hjus36/STM32-Flight-System/hardware/LKM_FC_V1/bom/LKM_FC_V1_BOM.pdf

STM32-Flight-System / hardware / LKM_FC_V1 / bom | ASSEMBLY BOM | 01

# LKM_FC_V1 | Assembly BOM

### STM32-Flight-System · 공장 실장용 부품 명세서 · Source: LKM_JLCPCB_BOM.csv

Unique MPN groups
52

구매·조립용 품목 그룹

Placements / board
139

보드 1장당 공장 실장

Placements / 5 boards
695

손실 여유 수량 제외

이 표는 JLCPCB 조립용 CSV를 바탕으로 작성했으며, 전체 회로도 146개 Component 목록과 다릅니다. 수동 실장 헤더(J1/J4/J5/J8), DNP(R58), 직접 배선용 J6, 별도 실장하지 않는 TP1은 공장 실장 목록에서 제외됩니다.

No. | Designator | Qty | Manufacturer | Manufacturer Part Number | Footprint | LCSC Part #
01 | BZ1 | 1 | Same Sky (formerly CUI Devices) | CMT-8540S-SMT-TR | CMT_8540S_SMT_TR_8P5X8P5_4LAND | C22359715
02 | C1 | 1 | Murata | GRM1885C1H332JA01D | TDK_C1608_0603_REFLOW | C77036
03 | C2,C9,C10,C11,C12,C13,C14,C17,C19,C24,C25,C26,C27,
| C30,C33,C34,C35,C36,C37,C39,C40,C42,C43,C44,C45 | 25 | TDK | C1608X7R1H104K080AA | TDK_C1608_0603_REFLOW | C72453
04 | C3,C4,C5,C6,C41 | 5 | TAIYO YUDEN | MCAST32MSB7226KPNA01 | TAIYO_YUDEN_MCAS_3225_REFLOW | C5372271
05 | C7,C18 | 2 | Murata | GCM1885C1H103JA16D | TDK_C1608_0603_REFLOW | C1517789
06 | C8 | 1 | Murata | GCM2195C1H153JA16D | MURATA_GCM21_0805_REFLOW | C161251
07 | C15,C38,C46 | 3 | Taiyo Yuden | MCJCG31LBB7106KTPA01 | TDK_C3216_1206_REFLOW | C5767734
08 | C16 | 1 | TDK | CGA3E1X7R1V105K080AE | TDK_C1608_0603_REFLOW | C2167404
09 | C20,C21,C31 | 3 | TDK | C1608X7R1A225K080AC | TDK_C1608_0603_REFLOW | C3853756
10 | C22,C23 | 2 | Murata | GCM1885C2A160FA16D | TDK_C1608_0603_REFLOW | C17345794
11 | C28,C29 | 2 | Murata | GCM1885C2A220FA16D | TDK_C1608_0603_REFLOW | C2169896
12 | C32 | 1 | TDK | CGA3E2X7R1H103K080AA | TDK_C1608_0603_REFLOW | C171819
13 | D1 | 1 | Littelfuse | SMAJ6.0CA | SMAJ6.0CA | C80275
14 | D2 | 1 | Diodes Incorporated | BZT52C5V1-7-F | BZT52C5V1_7F_SOD123_DIODES | C151588
15 | D3 | 1 | Littelfuse | SMAJ13A | SMAJ13A | C148214
16 | D4,D5,D6,D7,D8,D9,D10 | 7 | Texas Instruments | TPD2E2U06DRLR | TPD2E2U06DRLR_DRL5_P0.50 | C1972959
17 | D11 | 1 | Vishay | SS14-E3/61T | SS14_E3_61T_SMA_DO214AC | C47460
18 | D12,D15 | 2 | Kingbright | APT1608SURCK | APT1608SURCK_LED1608_1P6X0P8 | C5875723
19 | D13,D16 | 2 | Kingbright | APT1608SGC | APT1608SGC_LED1608_1P6X0P8 | C5875754
20 | D14 | 1 | Kingbright | APT1608SYCK | APT1608SYCK_LED1608_1P6X0P8 | C5875726
21 | J2,J3 | 2 | Molex | 530470510 | Molex_53047-0510 | C471412
22 | Q1 | 1 | Diodes Incorporated | DMP2035U-7 | DMP2035U7_SOT23_DIODES | C110499
23 | Q2 | 1 | Alpha & Omega Semiconductor | AO3400A | AO3400A_SOT23_AOS | C20917
24 | R1,R53,R54,R55,R57 | 5 | Vishay | CRCW06031K00FKEA | VISHAY_CRCW0603_REFLOW | C844920
25 | R2 | 1 | Vishay | CRCW0603240KFKEA | VISHAY_CRCW0603_REFLOW | C3008874
26 | R3,R40,R42,R44,R46,R48,R50,R52 | 8 | Vishay | CRCW0603100KFKEA | VISHAY_CRCW0603_REFLOW | C844916

STM32-Flight-System / hardware / LKM_FC_V1 / bom | ASSEMBLY BOM | 02
No. | Designator | Qty | Manufacturer | Manufacturer Part Number | Footprint | LCSC Part #
27 | R4 | 1 | Vishay | CRCW06031K02FKEA | VISHAY_CRCW0603_REFLOW | C844136
28 | R5 | 1 | Vishay | TNPW060331K6BEEA | VISHAY_TNPW0603_IPC_REFLOW | C843870
29 | R6 | 1 | Vishay | TNPW060310K1BEEA | VISHAY_TNPW0603_IPC_REFLOW | C4353204
30 | R7 | 1 | Vishay | CRCW0603620RFKEA | VISHAY_CRCW0603_REFLOW | C844181
31 | R8 | 1 | Vishay | TNPW0603100KBEEA | VISHAY_TNPW0603_IPC_REFLOW | C844888
32 | R9 | 1 | Vishay | TNPW060310K0BEEA | VISHAY_TNPW0603_IPC_REFLOW | C844890
33 | R10 | 1 | Vishay | TNPW06031K00BEEA | VISHAY_TNPW0603_IPC_REFLOW | C844891
34 | R11 | 1 | Vishay | TNPW060347K0BEEA | VISHAY_TNPW0603_IPC_REFLOW | C2089026
35 | R12,R15,R16 | 3 | Vishay | CRCW06030000Z0EA | VISHAY_CRCW0603_REFLOW | C844915
36 | R13,R14,R17,R18,R19,R20,R23,R24,R25 | 9 | Vishay | CRCW060310K0FKEA | VISHAY_CRCW0603_REFLOW | C844918
37 | R21,R22,R26,R27,R56 | 5 | Vishay | CRCW06032K20FKEA | VISHAY_CRCW0603_REFLOW | C844925
38 | R28,R31,R36,R39,R41,R43,R45,R47,R49 | 9 | Vishay | CRCW060333R0FKEA | VISHAY_CRCW0603_REFLOW | C844927
39 | R29,R32,R34,R37,R51 | 5 | Vishay | CRCW0603100RFKEA | VISHAY_CRCW0603_REFLOW | C844917
40 | R30,R33,R35,R38 | 4 | Vishay | CRCW060347K0FKEA | VISHAY_CRCW0603_REFLOW | C844929
41 | SW1 | 1 | Omron | B3U-1000P | B3U1000P_SMD_3X2P5 | C231329
42 | U1 | 1 | STMicroelectronics | STM32F405RGT6 | STM32F405RGT6_LQFP64_10X10_P0.50_ST | C15742
43 | U2 | 1 | CEVA | BNO086 | BNO086_LGA28_5.2X3.8_P0.50_CEVA | C5264422
44 | U3 | 1 | TDK InvenSense | ICM-20602 | ICM20602_LGA16_3X3_P0.50 | C97633
45 | U4 | 1 | STMicroelectronics | LPS22HHTR | LPS22HH_HLGA10_2X2_P0.50 | C2827824
46 | U5 | 1 | Microchip | AT24C08C-SSHM-T | AT24C08C_SOIC8_SN_P1.27 | C31422
47 | U8 | 1 | Texas Instruments | TPS259531DSGR | TPS259531DSGR_WSON8_DSG_2X2_P0.50_EP | C2155674
48 | U9 | 1 | Texas Instruments | TPS7A9001DSKR | TPS7A9001DSKR_WSON10_DSK_2.5X2.5_P0.50_EP | C840111
49 | U10 | 1 | Texas Instruments | TMUX1511PWR | TMUX1511PWR_TSSOP14_PW_4.4X5_P0.65 | C2866750
50 | U11,U12,U13,U14 | 4 | Texas Instruments | SN74LVC1G17DBVR | SN74LVC1G17DBVR_DBV5_P0.95 | C7836
51 | Y1 | 1 | Abracon | ABM3B-8.000MHZ-10-D1G-T | ABM3B_8MHZ_5032_4PAD | C1985378
52 | Y2 | 1 | Abracon | ABS07-32.768KHZ-T | ABS07_32K768_3215_2PAD | C130253

참고: Designator 및 Quantity는 CSV와 대조되었으며 52개 그룹·139개 고유 실장 위치로 일치합니다. Footprint 명칭은 라이브러리 이름으로, 실제 Manufacturer 및 MPN과 항상 동일한 이름을 갖는 것은 아닙니다. 최종 주문 및 조립 가능 여부는 제조사에서 별도로 확인해야 합니다.
