hjus36/STM32-Flight-System/testing/offline-sil/results/sil_v1_20261106_040855/trace_all_scenarios.csv

scenario | t_ms | t_s | injection | target_roll_deg | roll_deg | target_pitch_deg | pitch_deg | roll_rate_rad_s | pitch_rate_rad_s | requested_roll_torque_nm | achieved_roll_torque_nm | requested_pitch_torque_nm | achieved_pitch_torque_nm | motor1_model_n | motor2_model_n | motor3_model_n | motor4_model_n | virtual_valid | esc_enabled | controller_ready | actuator_state | actuator_result | bno_age_ms | icm_age_ms | host_skew_ms | timepair_result | frame_result | buffer_result | scheduler_result | preview_result | mixer_ok | model_step_count
baseline | 10 | 0.010 | 0 | 0.000000 | 0.000000 | 0.000000 | 0.000000 | 0.0000000 | 0.0000000 | 0.0000000 | 0.0000000 | 0.0000000 | 0.0000000 | 0.0000000 | 0.0000000 | 0.0000000 | 0.0000000 | 0 | 0 | 0 | 1 | DISARMED | 2 | 1 | 1 | OBSERVATION_ONLY | SYNTHETIC_ONLY | OK | OK | FEEDBACK | 0 | 0
baseline | 20 | 0.020 | 0 | 0.000000 | 0.000000 | 0.000000 | 0.000000 | 0.0000000 | 0.0000000 | 0.0000000 | 0.0000000 | 0.0000000 | 0.0000000 | 0.0000000 | 0.0000000 | 0.0000000 | 0.0000000 | 0 | 0 | 0 | 2 | ARMED_VIRTUAL | 2 | 1 | 1 | OBSERVATION_ONLY | SYNTHETIC_ONLY | OK | OK | FEEDBACK | 0 | 0
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
