hjus36/STM32-Flight-System/hardware/LKM_FC_V1/pcb-layout/LKM_FC_V1_PCB_Layout.pdf

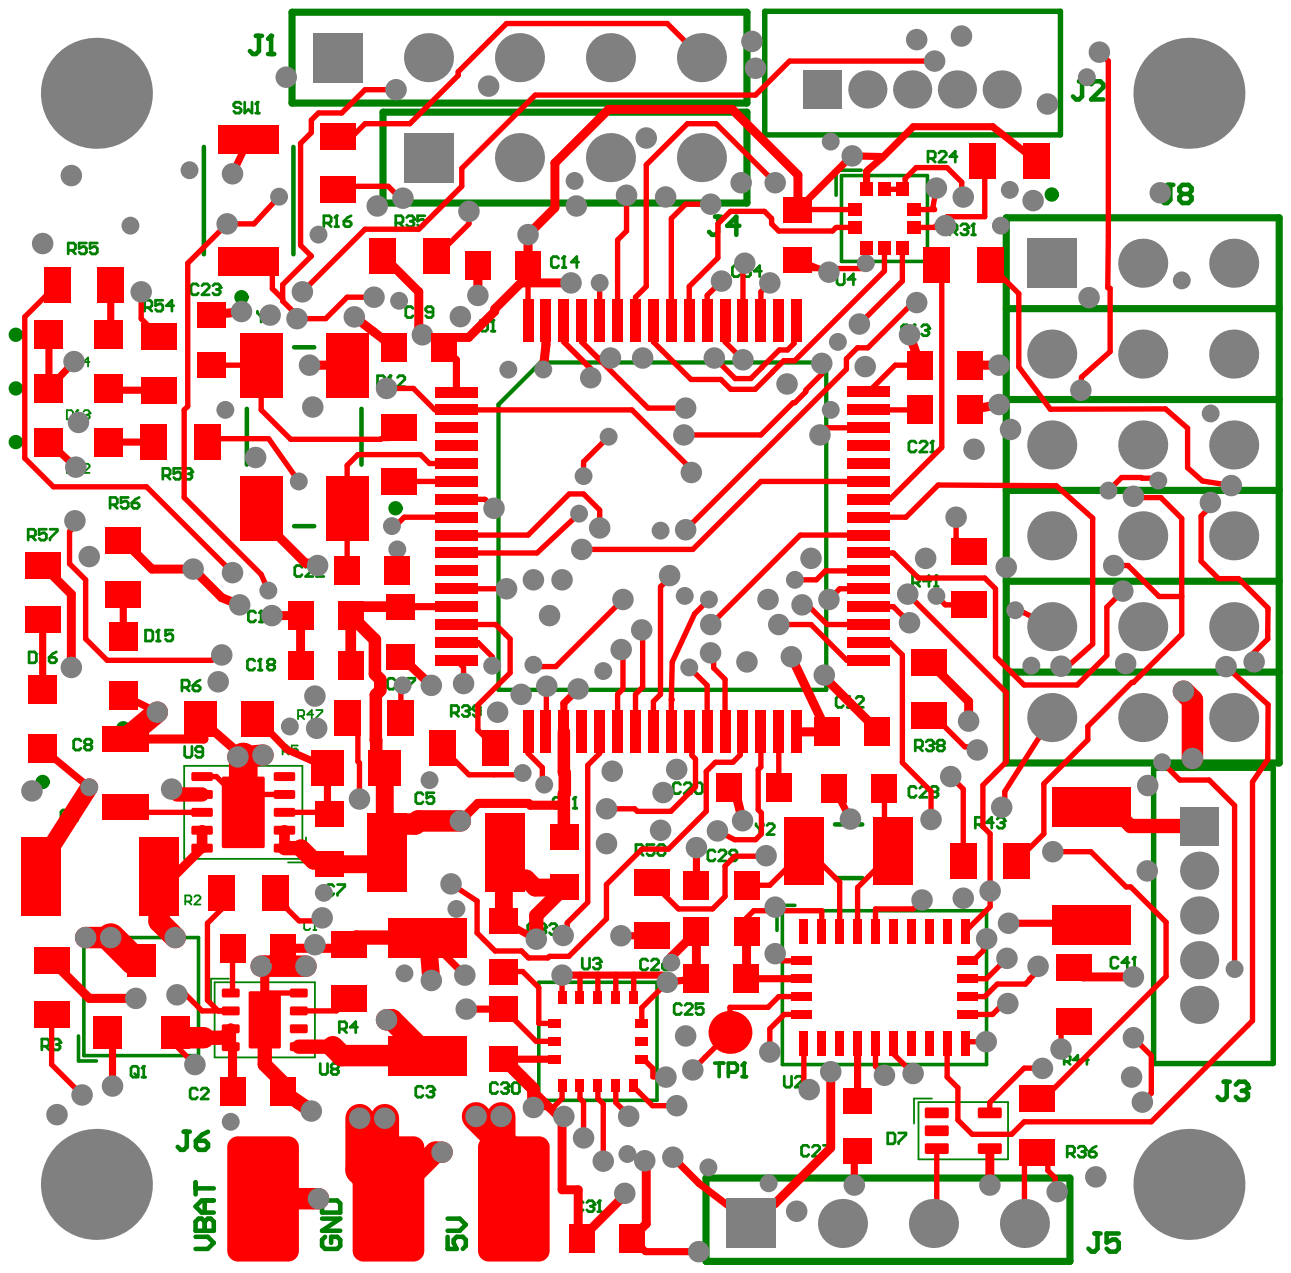
[picture p9: page 1]

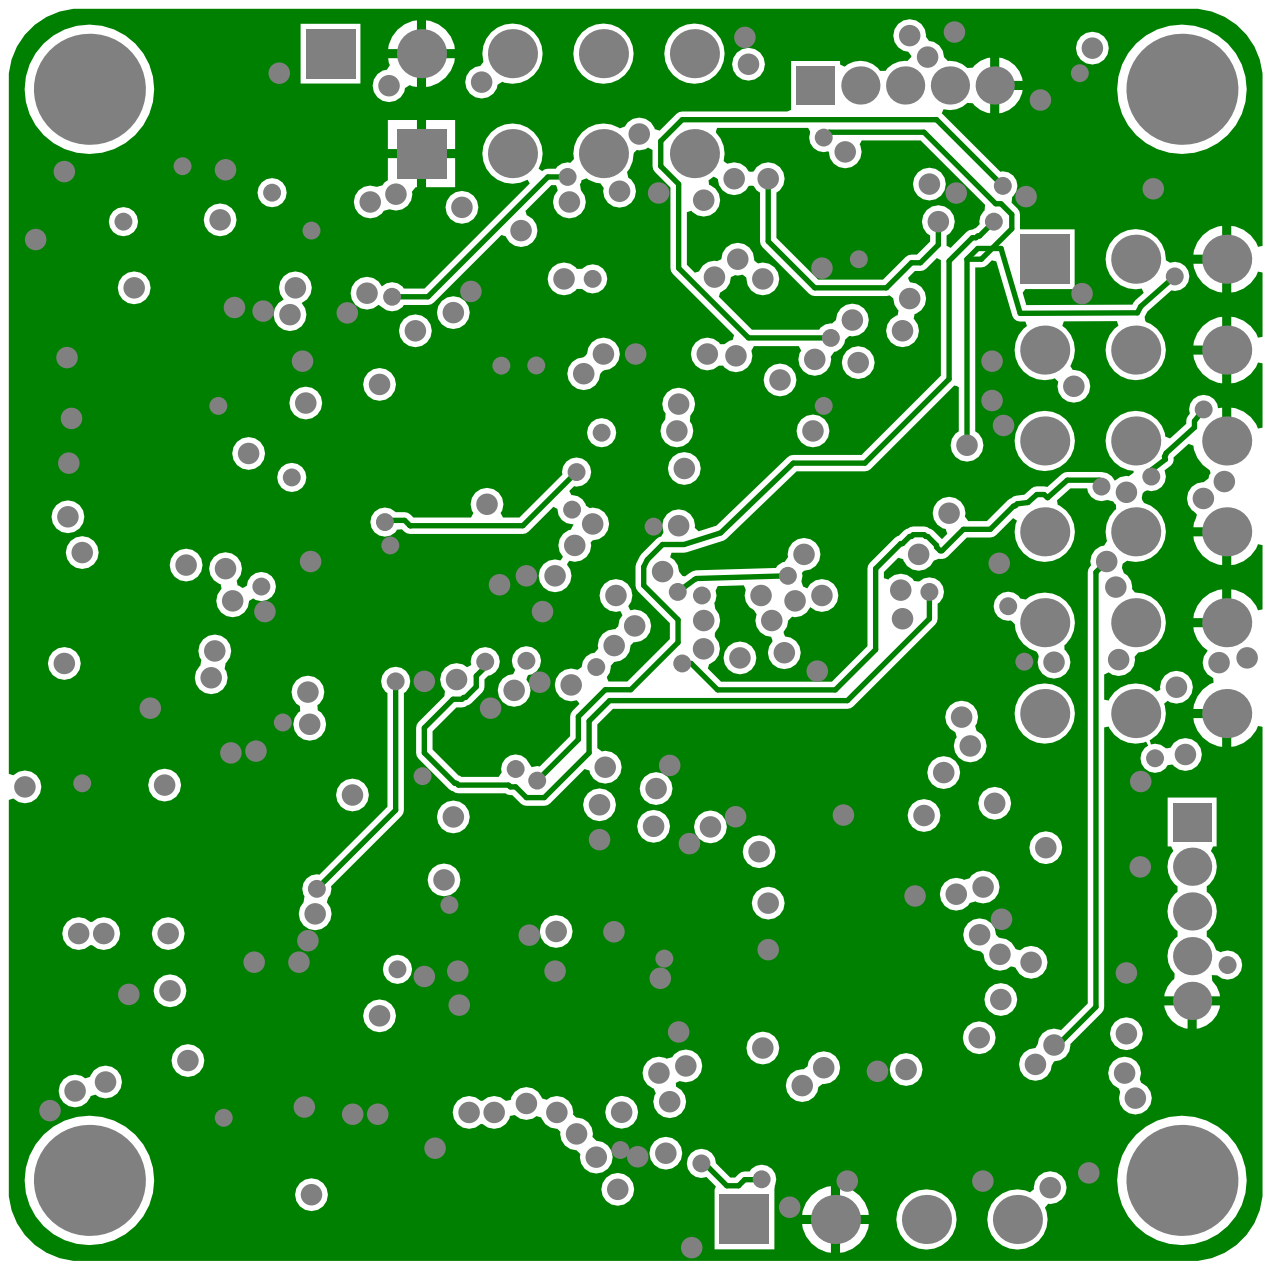
[picture p10: page 2]

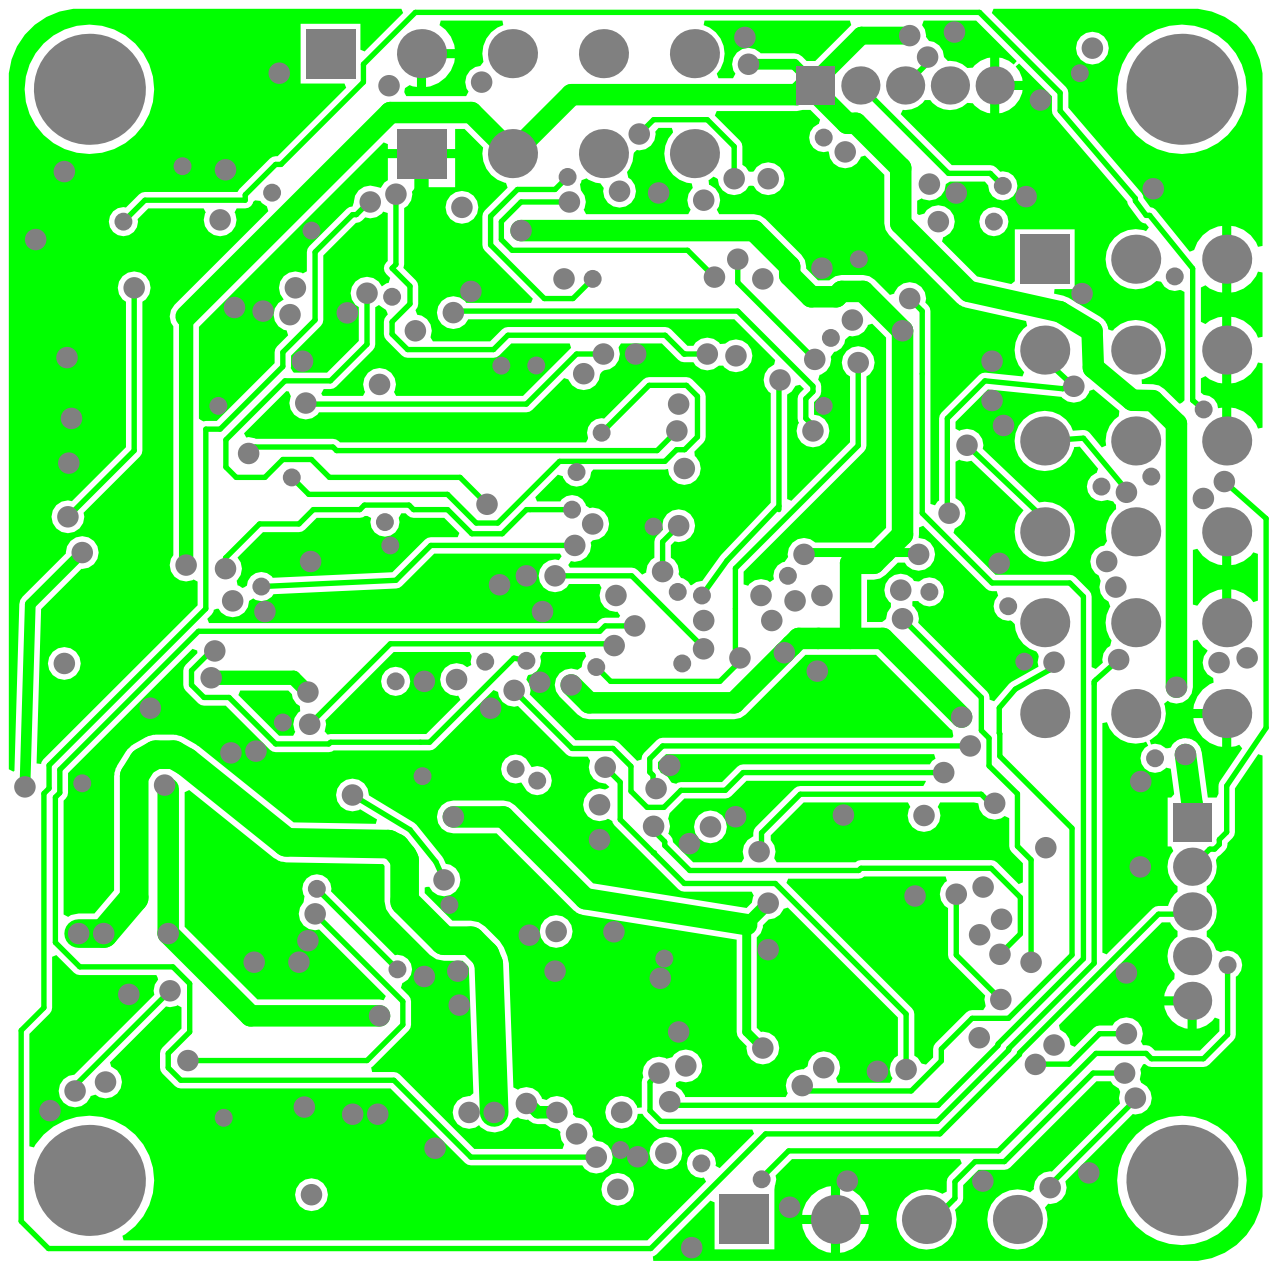
[picture p11: page 3]

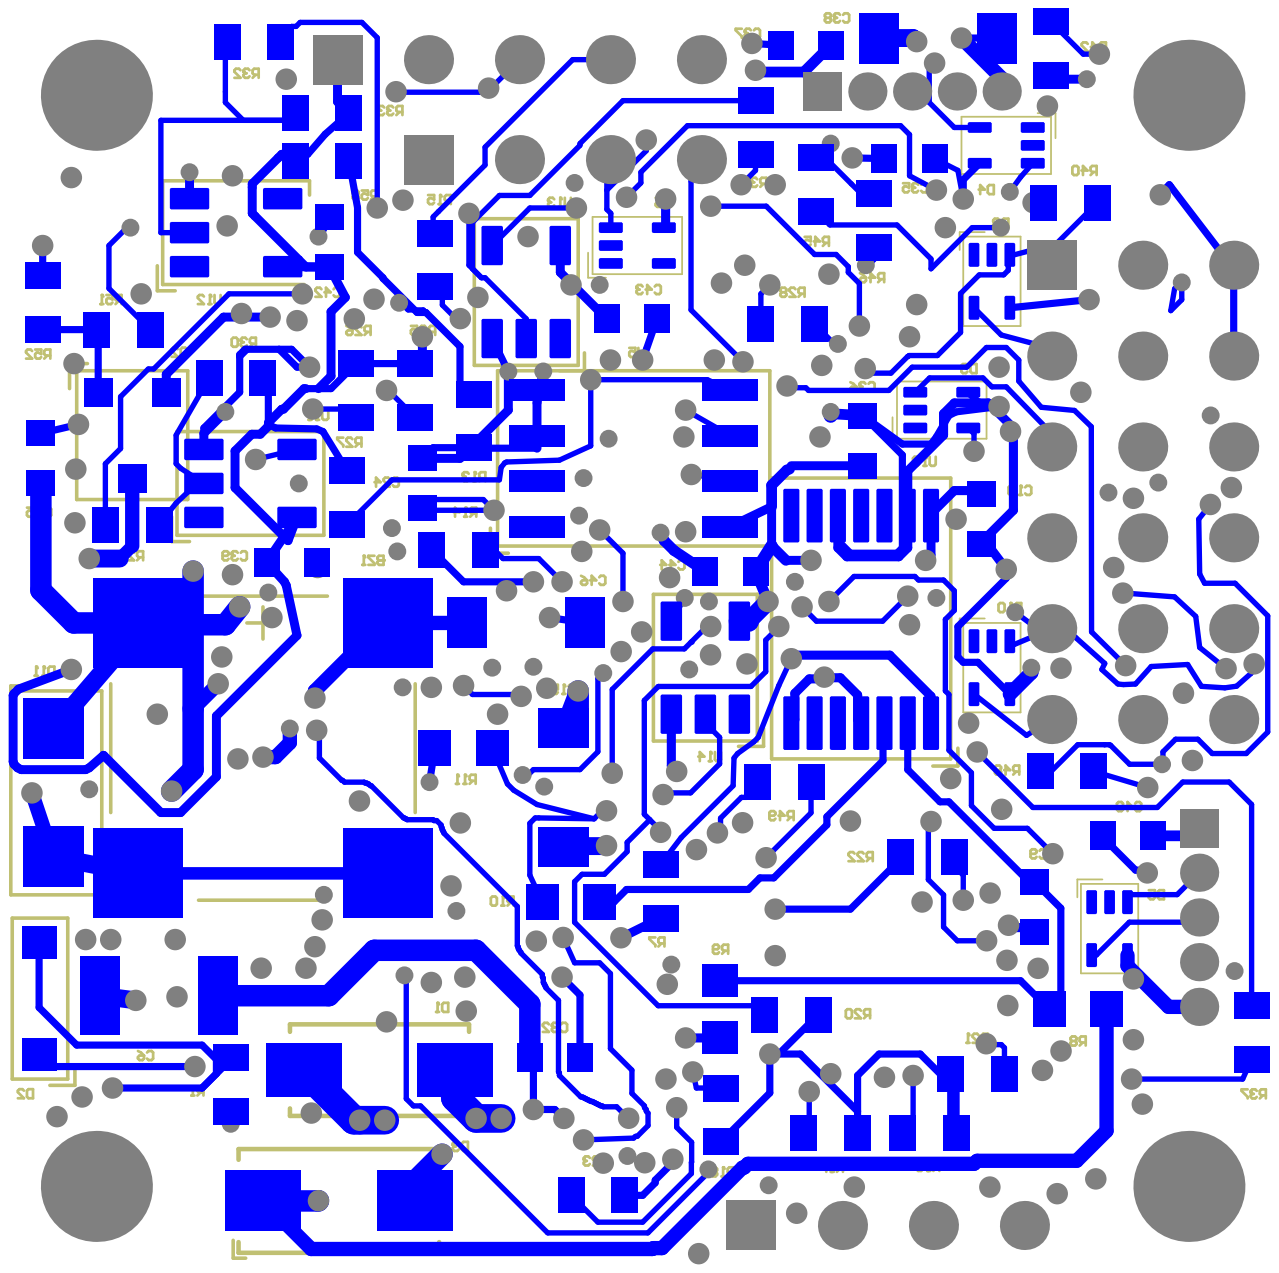
[picture p12: page 4]
