hjus36/STM32-Flight-System/hardware/LKM_FC_V1/schematic/LKM_FC_V1_Schematic.pdf

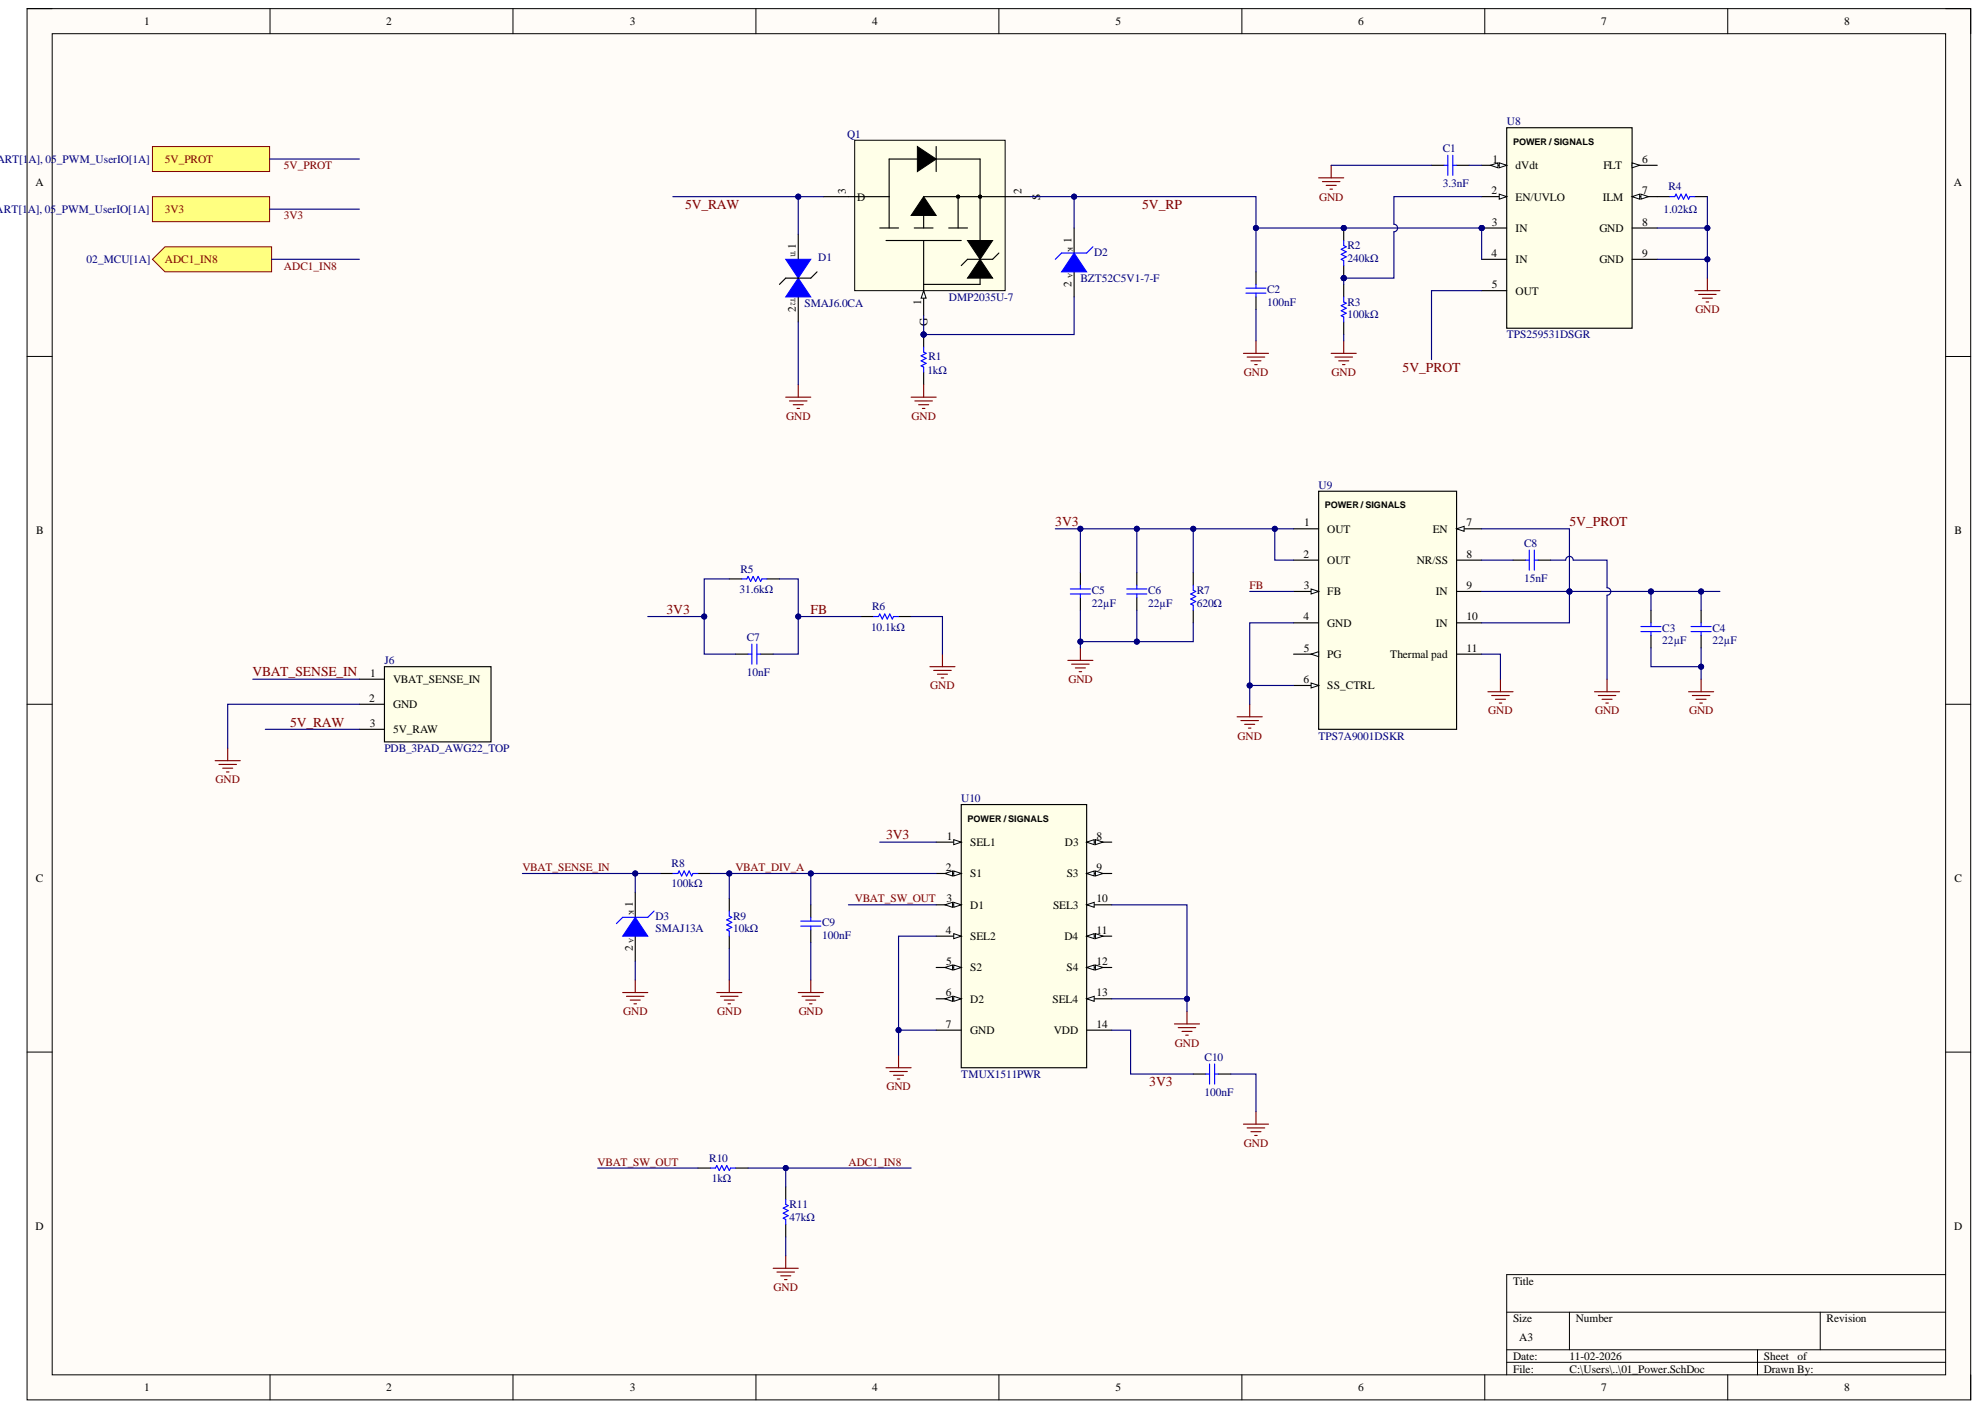
[picture p13: page 1]

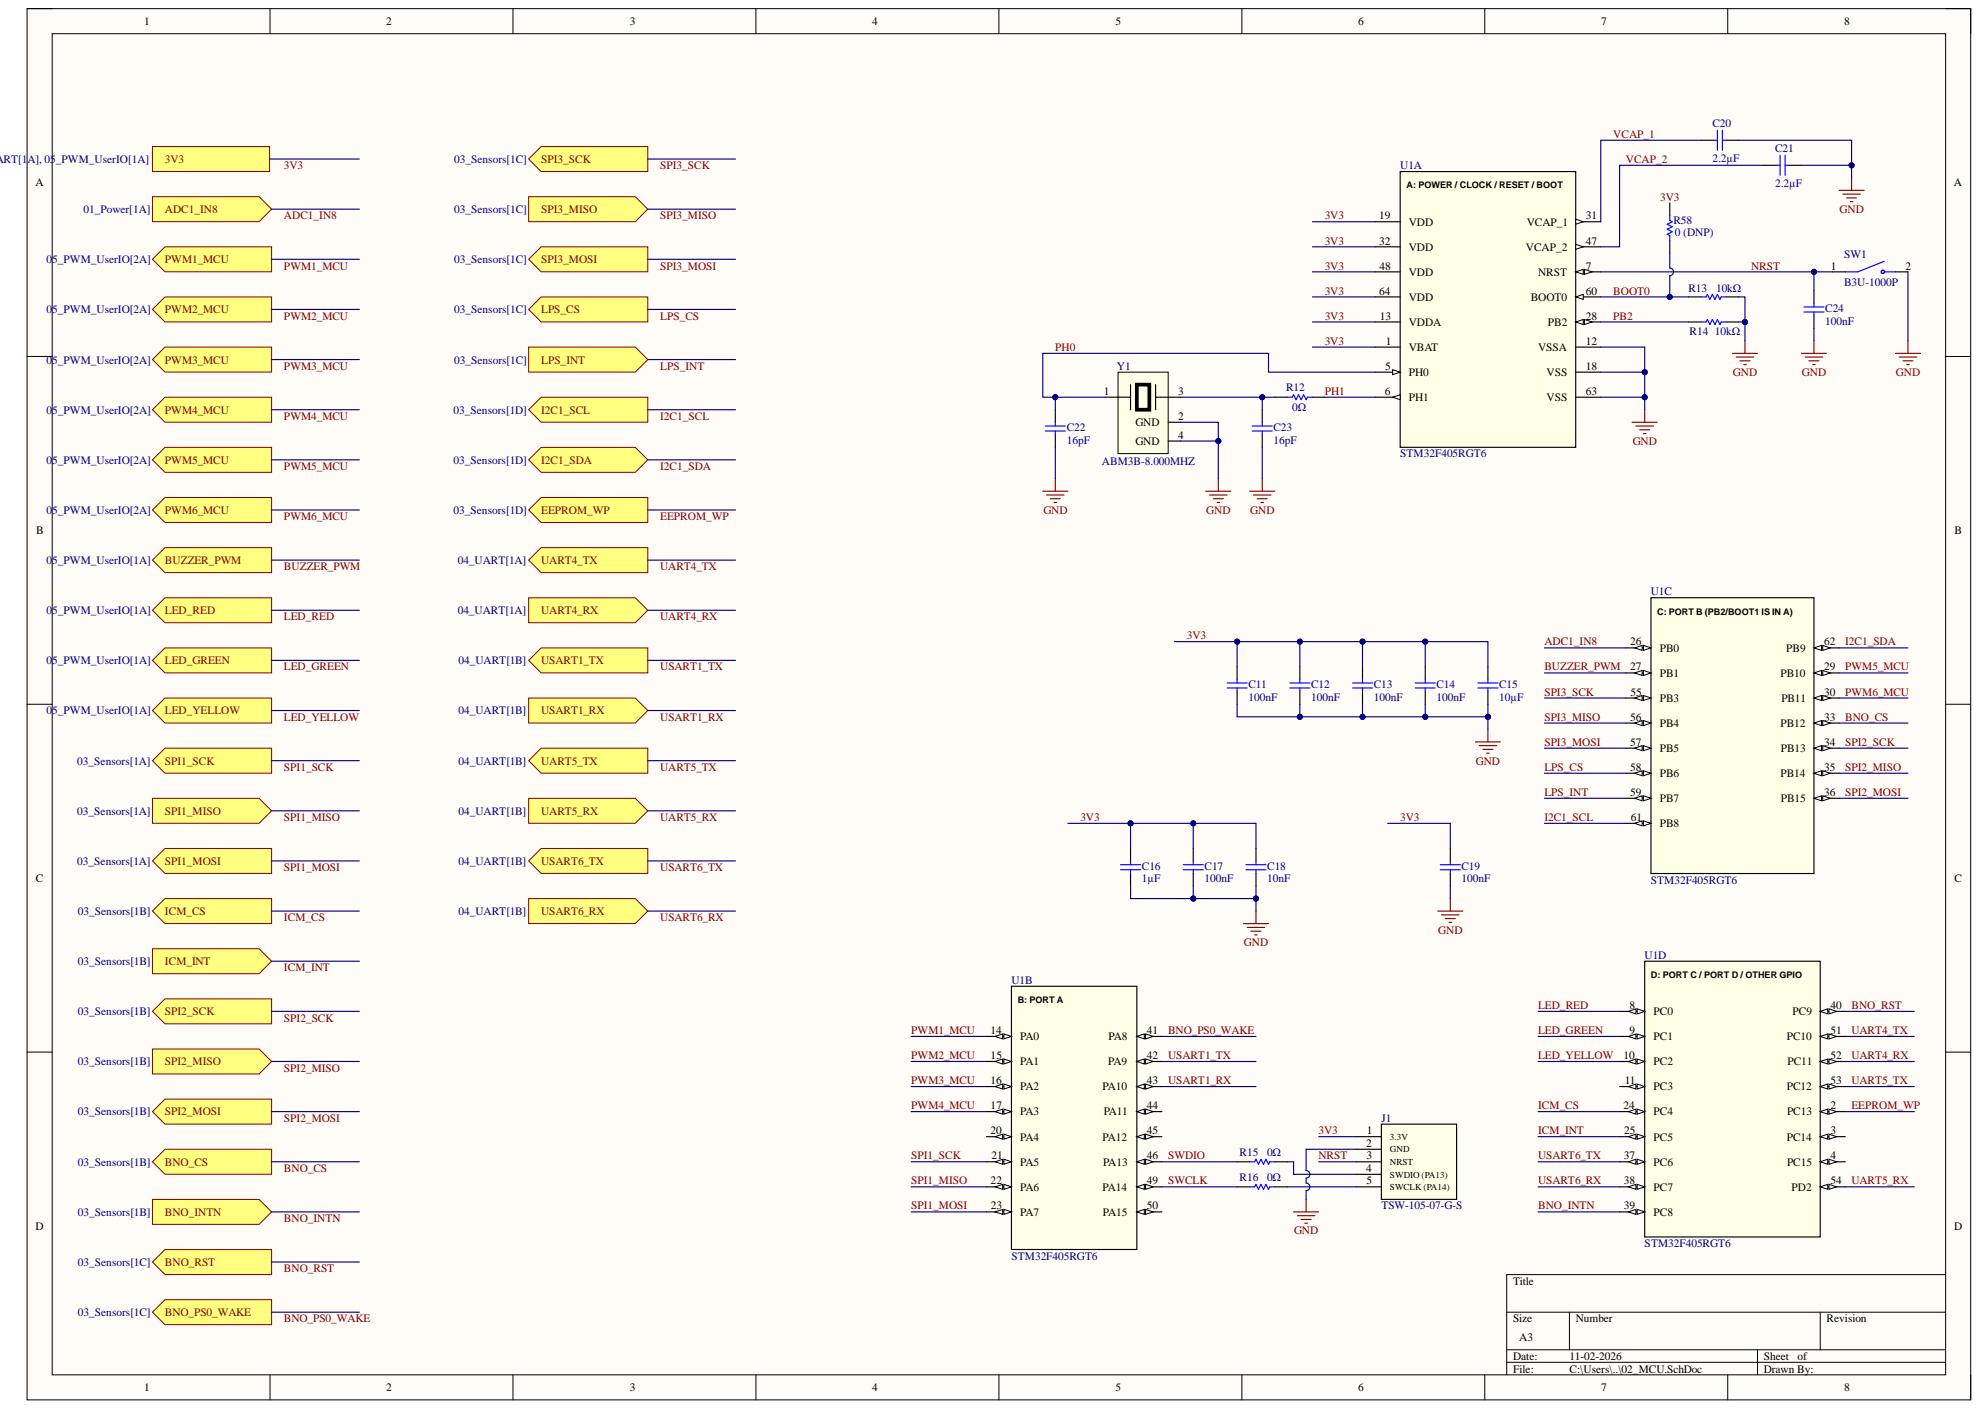
[picture p14: page 2]

SWCL K R1 Ω | | 4

NRS T | 3

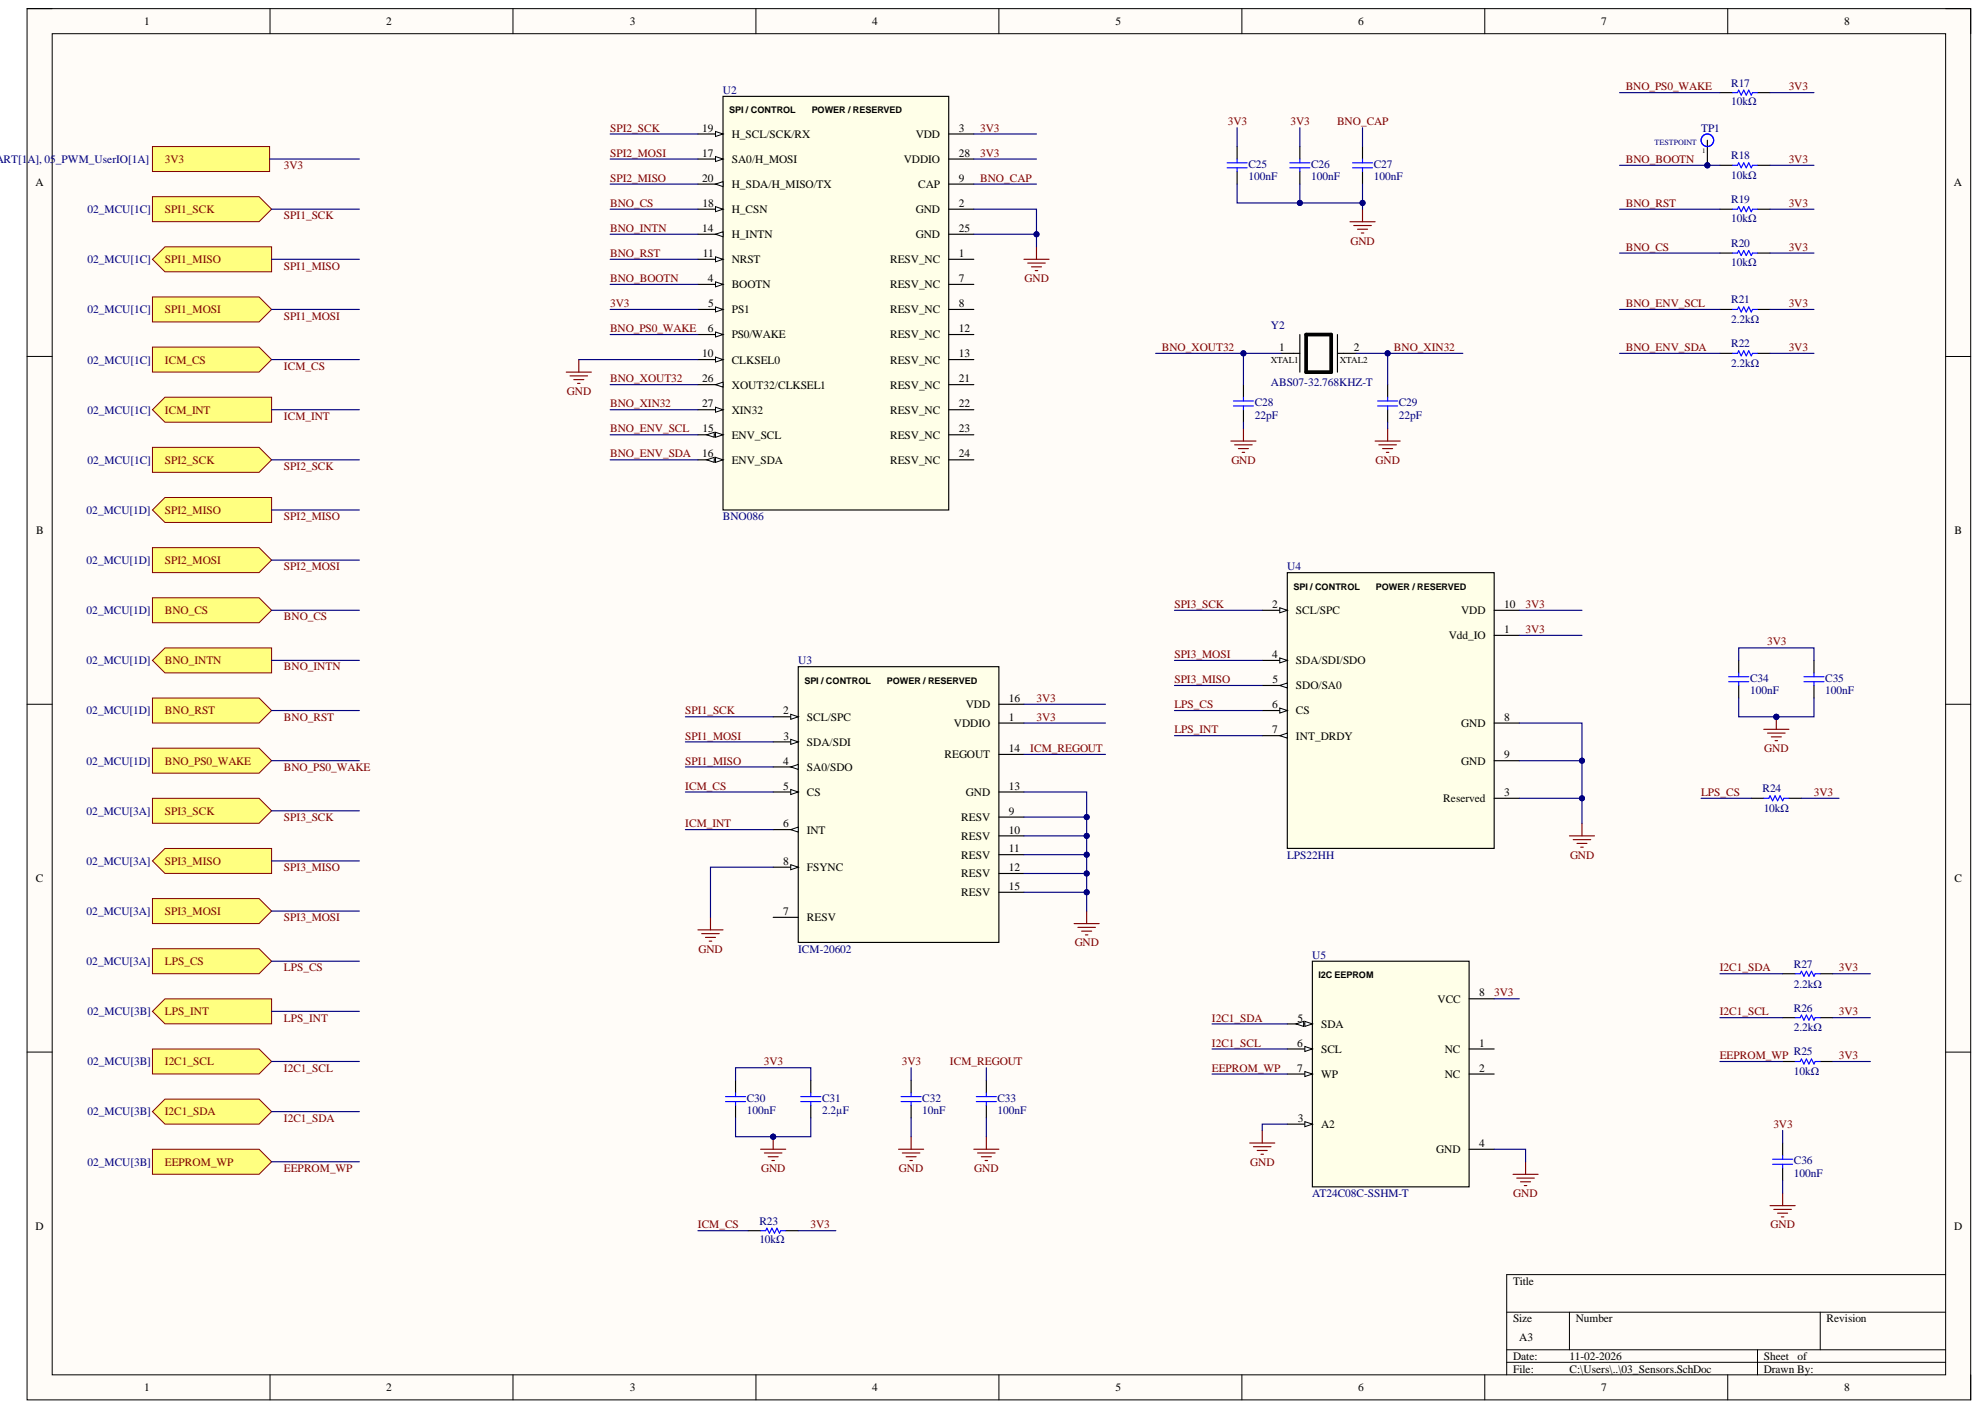
[picture p15: page 3]

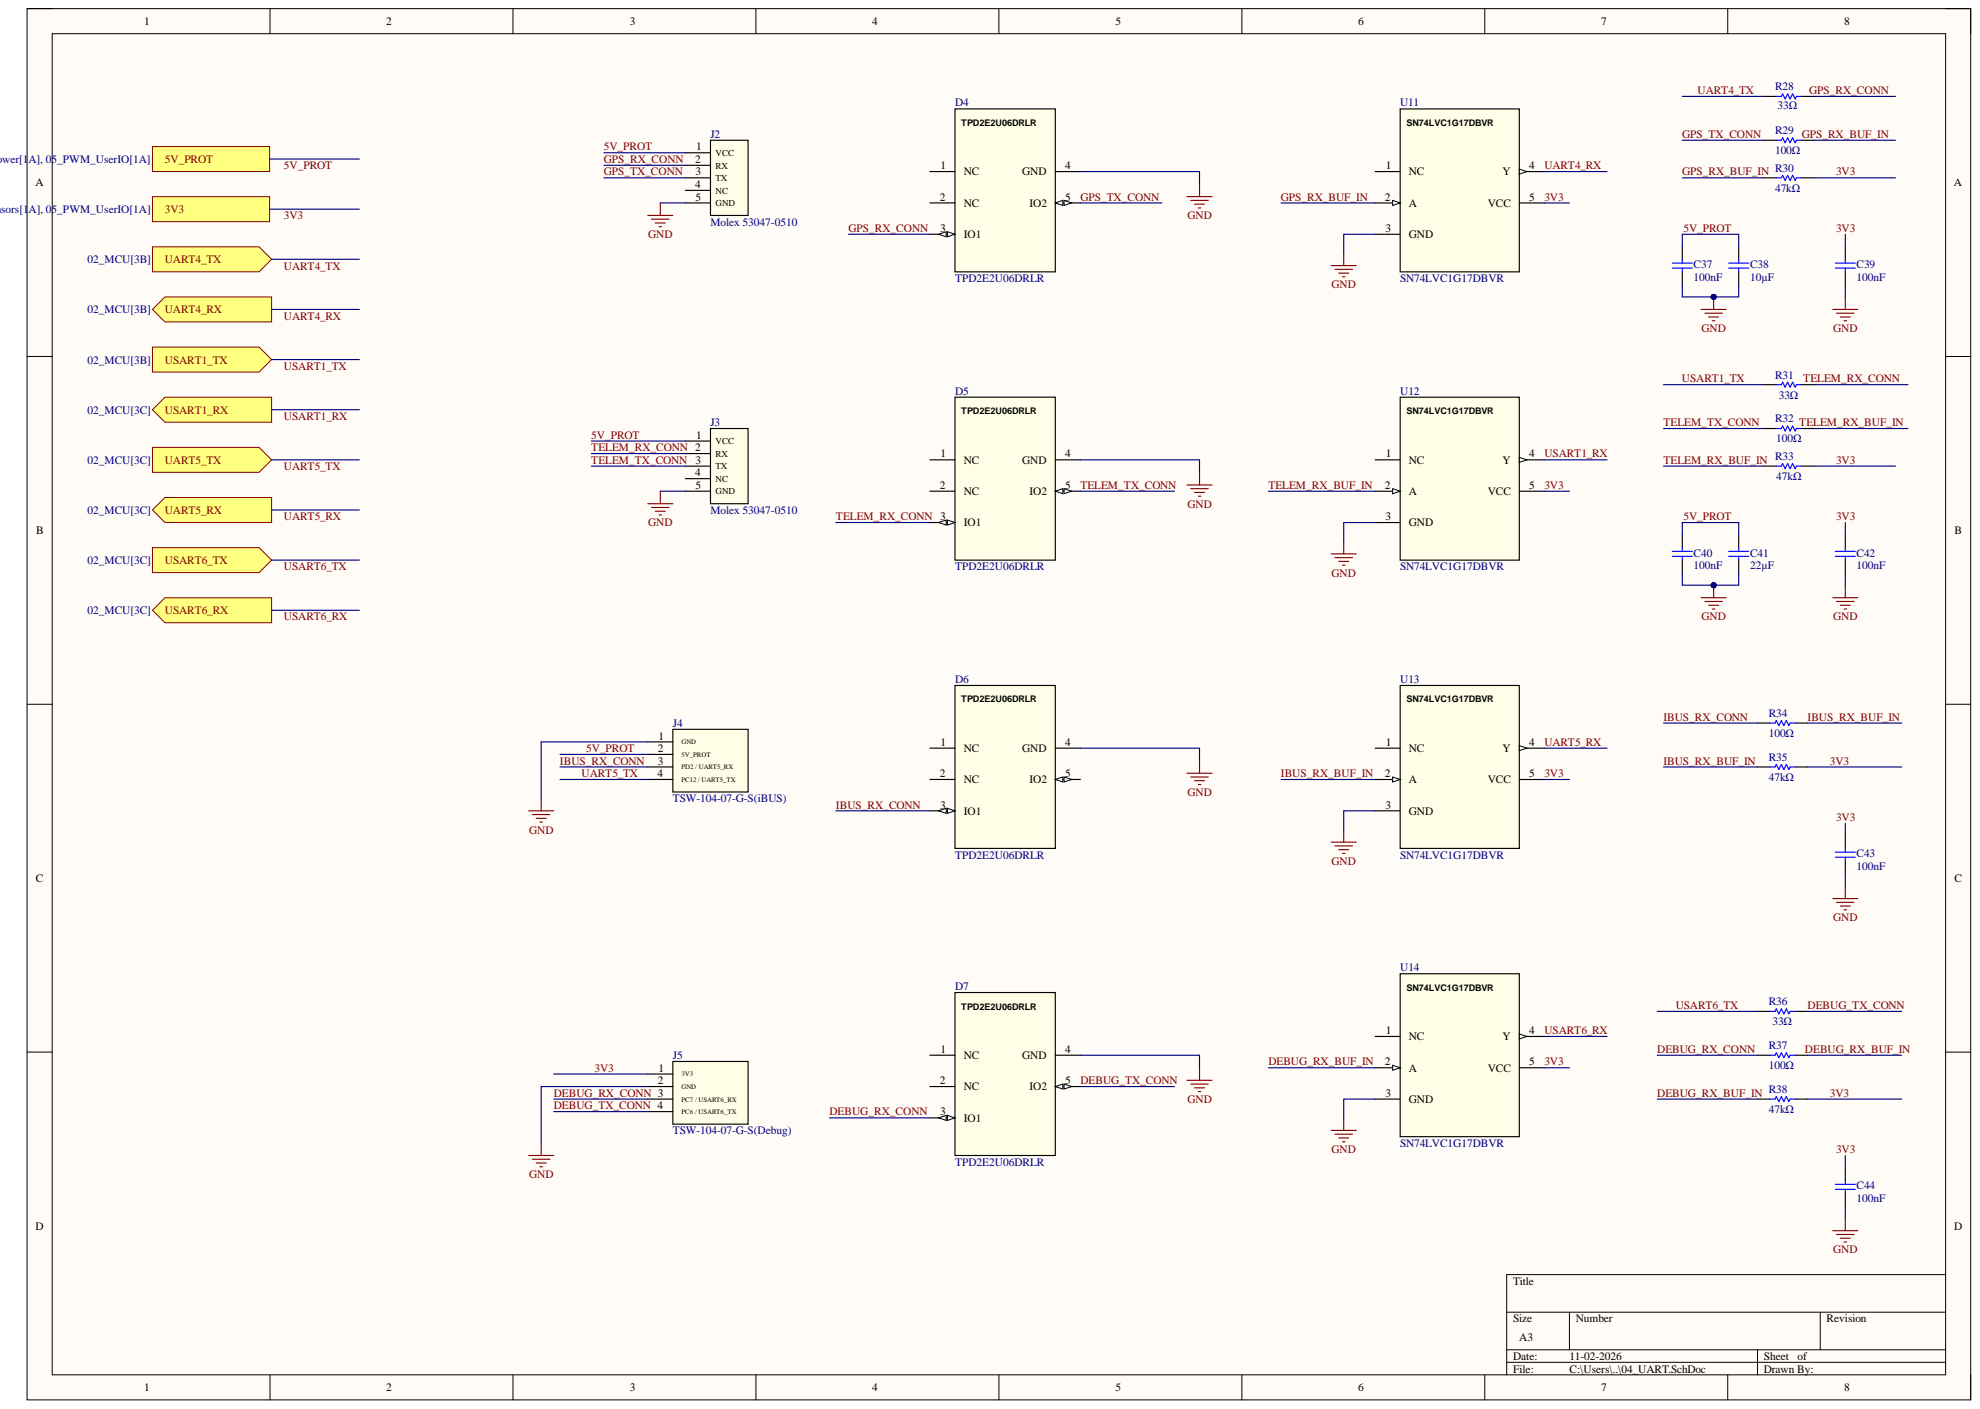
[picture p16: page 4]

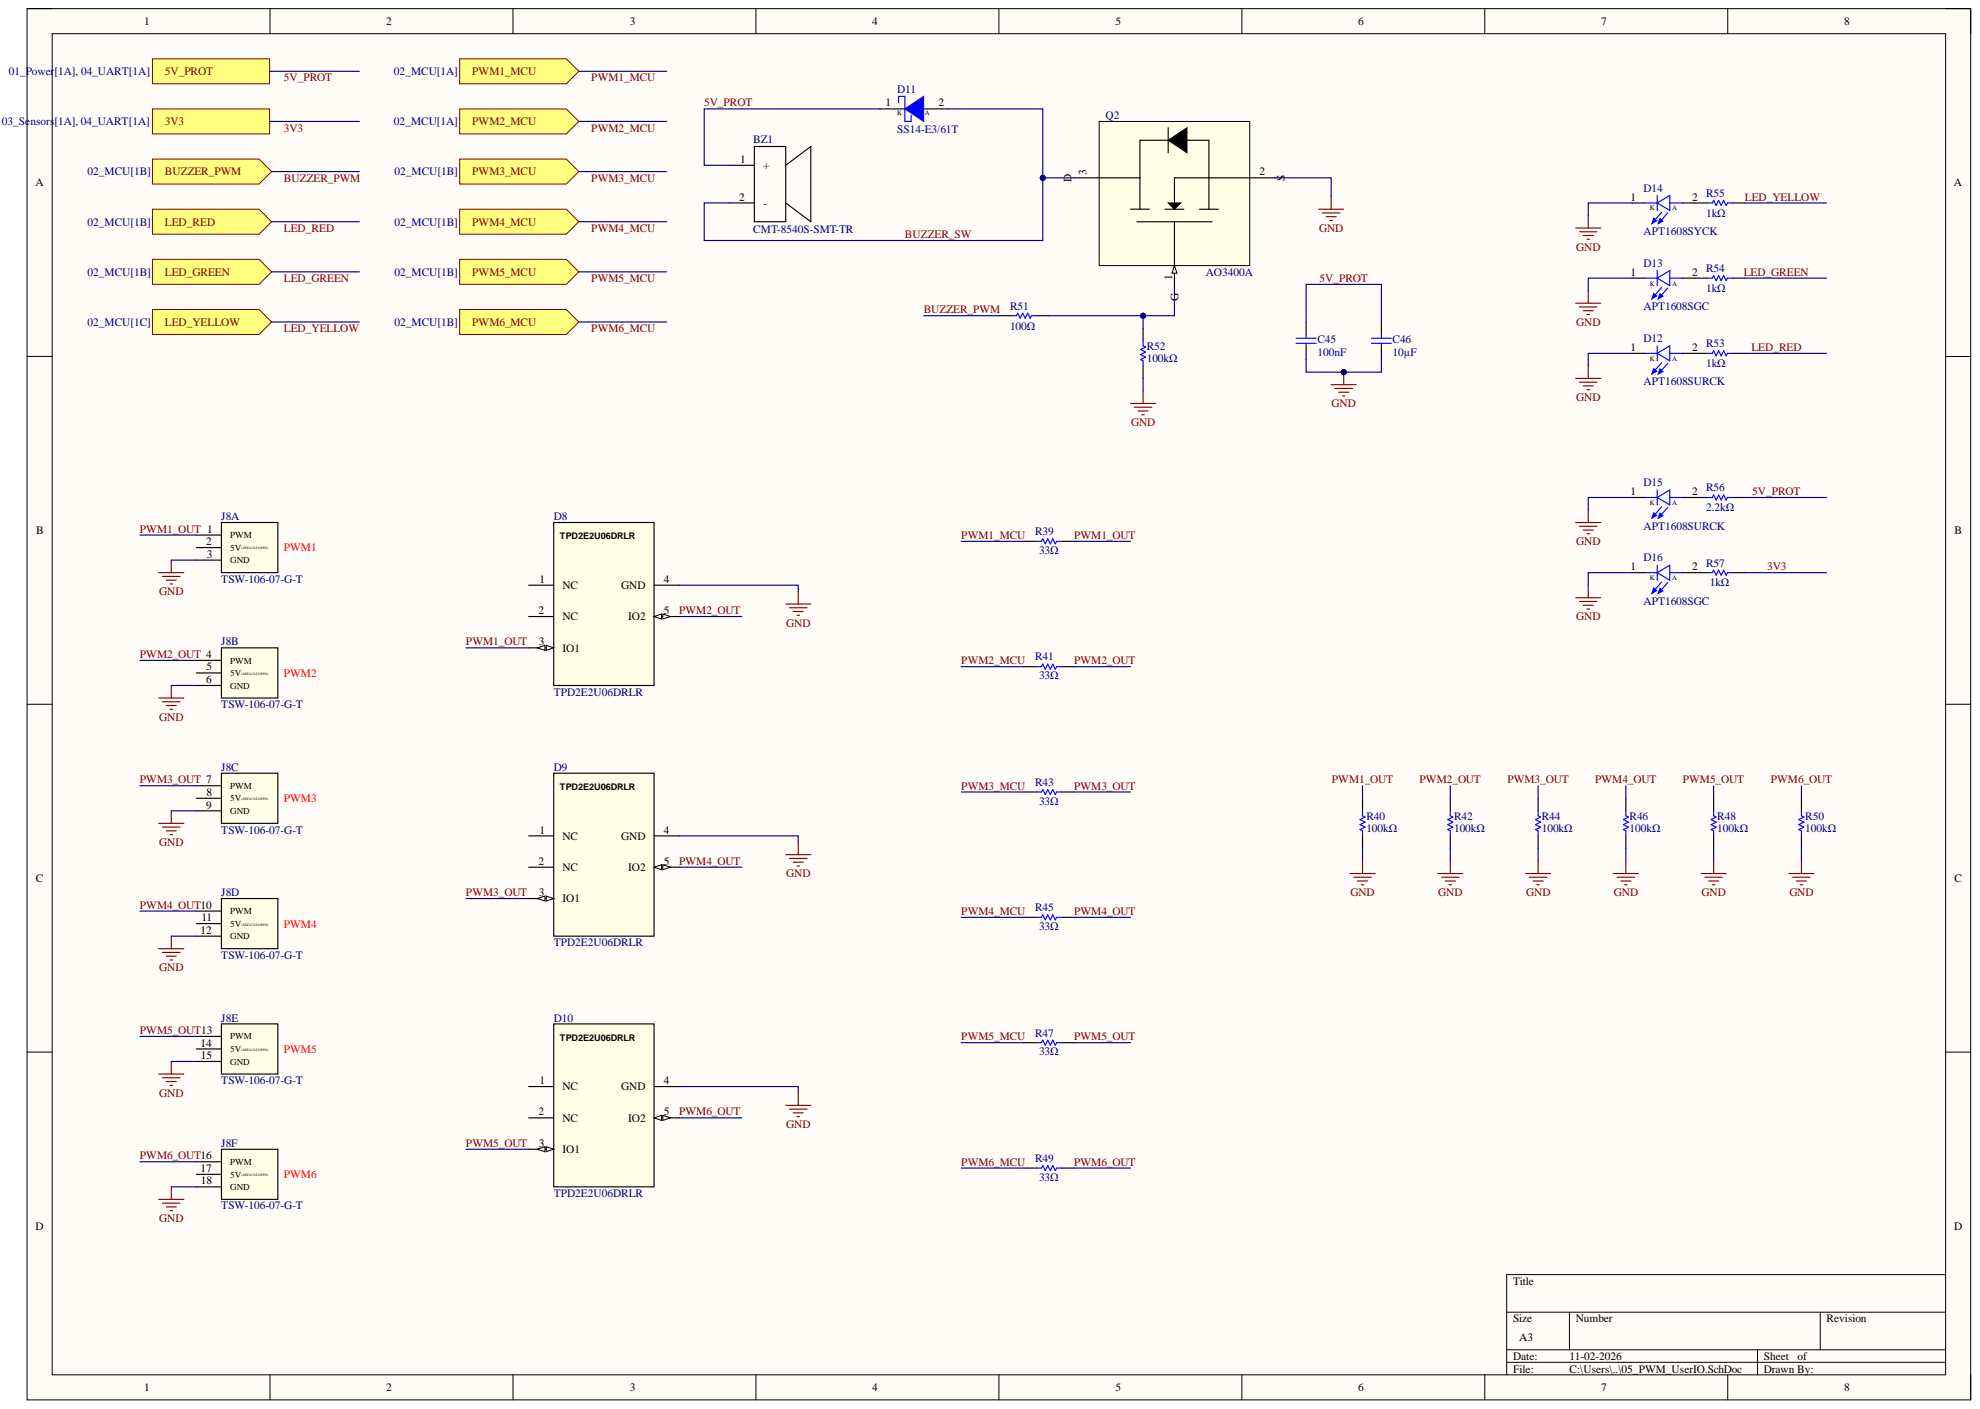
[picture p17: page 5]
