hjus36/STM32-Flight-System/firmware/stm32/LKM_BNO086_Bringup/Core/Src/main.c

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
/* Includes ------------------------------------------------------------------*/
#include "main.h"
#include "spi.h"
#include "usart.h"
#include "gpio.h"

/* USER CODE BEGIN Includes */

#include "lkm_bno086_diag.h"
#include "lkm_bno086_uart_diag.h"
#include "lkm_dual_imu_diag.h"
#include "lkm_fc100hz_bridge.h"
#include "lkm_aw_shadow.h"
#include "lkm_rp_frame_monitor.h"
#include "lkm_fc_actuator_monitor.h"
/* USER CODE END Includes */


void SystemClock_Config(void);
/**
  * @brief  The application entry point.
  * @retval int
  */
int main(void)
{

  /* MCU Configuration--------------------------------------------------------*/

  /* Reset of all peripherals, Initializes the Flash interface and the Systick. */
  HAL_Init();

  /* Configure the system clock */
  SystemClock_Config();

  /* Initialize all configured peripherals */
  MX_GPIO_Init();
  MX_SPI2_Init();
  MX_USART6_UART_Init();
  MX_SPI1_Init();
  /* USER CODE BEGIN 2 */

    LKM_BNO086_Diag_Init();
    LKM_BNO086_UartDiag_Init();
    LKM_DualIMU_Diag_Init(false); /* ICM-20602 SPI1 access disabled until PCB verification */
    LKM_FC100Hz_Bridge_Init(HAL_GetTick());
    LKM_AW_Shadow_Init(HAL_GetTick(), false); /* SHADOW OFF in firmware */
    LKM_RP_FrameMonitor_Init(); /* FRAME LOCKED; NO PID/ESC */
    LKM_FC_ActuatorMonitor_Init(); /* HARD LOCKED: NO ESC */
  /* USER CODE END 2 */

  /* Infinite loop */
  /* USER CODE BEGIN WHILE */
  while (1)
  {
    /* USER CODE END WHILE */

    /* USER CODE BEGIN 3 */
    LKM_BNO086_Diag_Service();
    LKM_BNO086_UartDiag_Service();
    LKM_DualIMU_Diag_Service();
    LKM_FC100Hz_Bridge_Service();
    LKM_AW_Shadow_Service(HAL_GetTick());
    LKM_RP_FrameMonitor_Service();
    LKM_FC_ActuatorMonitor_Service();
  }
  /* USER CODE END 3 */
}

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
