hjus36/STM32-Flight-System/firmware/stm32/LKM_BNO086_Bringup/Core/Inc/MW_target_hardware_resources.h

#ifndef PORTABLE_WORDSIZES
#ifdef __MW_TARGET_USE_HARDWARE_RESOURCES_H__
#ifndef __MW_TARGET_HARDWARE_RESOURCES_H__
#define __MW_TARGET_HARDWARE_RESOURCES_H__

#define MW_MULTI_TASKING_MODE 1
#include "mw_stm32_board_header.h"
#include "SysTickScheduler.h"
#include "arm_cortex_m_multitasking.h"

#define MW_USECODERTARGET 1
#define MW_TARGETHARDWARE "STM32F4xx Based"
#define MW_EXTMODEPROTOCOLINFO_SERIAL_HOSTINTERFACE Simulink
#define MW_EXTMODEPROTOCOLINFO_SERIAL_LOGGINGBUFFERAUTO 1
#define MW_EXTMODEPROTOCOLINFO_SERIAL_LOGGINGBUFFERSIZE 1024
#define MW_EXTMODEPROTOCOLINFO_SERIAL_LOGGINGBUFFERNUM 3
#define MW_EXTMODEPROTOCOLINFO_SERIAL_MAXCONTIGSAMPLES 10
#define MW_EXTMODEPROTOCOLINFO_CAN_HOSTINTERFACE Simulink
#define MW_EXTMODEPROTOCOLINFO_CAN_LOGGINGBUFFERAUTO 1
#define MW_EXTMODEPROTOCOLINFO_CAN_LOGGINGBUFFERSIZE 1000
#define MW_EXTMODEPROTOCOLINFO_CAN_LOGGINGBUFFERNUM 3
#define MW_EXTMODEPROTOCOLINFO_CAN_MAXCONTIGSAMPLES 10
#define MW_CONNECTIONINFO_SERIAL_BAUDRATE stm32cube.codegen.getConnectivityBaudrate(hCS)
#define MW_CONNECTIONINFO_SERIAL_COMPORT stm32cube.codegen.getConnectivityCOMPort(hCS)
#define MW_CONNECTIONINFO_SERIAL_VERBOSE 1
#define MW_CONNECTIONINFO_TCPIP_IPADDRESS stm32cube.parameters.EthernetConfigIPAddressExternalMode(hCS)
#define MW_CONNECTIONINFO_TCPIP_PORT 17725
#define MW_CONNECTIONINFO_TCPIP_VERBOSE 1
#define MW_CONNECTIONINFO_CAN_CANVENDOR matlab:stm32cube.codegen.getXCPonCANConnectivity(hCS,'Vendor')
#define MW_CONNECTIONINFO_CAN_CANDEVICE matlab:stm32cube.codegen.getXCPonCANConnectivity(hCS,'Device')
#define MW_CONNECTIONINFO_CAN_CANCHANNEL stm32cube.codegen.getXCPonCANConnectivity(hCS,'Channel')
#define MW_CONNECTIONINFO_CAN_BUSSPEED stm32cube.codegen.getXCPonCANConnectivity(hCS,'Baudrate')
#define MW_CONNECTIONINFO_CAN_CANIDCOMMAND stm32cube.codegen.getXCPonCANConnectivity(hCS,'CANIDCommand')
#define MW_CONNECTIONINFO_CAN_CANIDRESPONSE stm32cube.codegen.getXCPonCANConnectivity(hCS,'CANIDResponse')
#define MW_CONNECTIONINFO_CAN_ISCANIDEXTENDED stm32cube.codegen.getXCPonCANConnectivity(hCS,'IsCANIDExtended')
#define MW_CONNECTIONINFO_CAN_VERBOSE 1
#define MW_EXTMODE_CONFIGURATION Serial
#define MW_EXTMODE_TARGETWAITFORCONNECTION 1
#define MW_EXTMODE_USEREALTIMESTAMPLOGGING 1
#define MW_RTOS Baremetal
#define MW_RTOSBASERATETASKPRIORITY 40
#define MW_SCHEDULER_INTERRUPT_SOURCE 0
#define MW_RUNTIME_BUILDACTION 0
#define MW_RUNTIME_RUNTIMELIBRARY 0
#define MW_RUNTIME_FLOATABI 2
#define MW_RUNTIME_FFPCONTRACTION 1
#define MW_RUNTIME_DISABLEPARALLELBUILD 0
#define MW_RUNTIME_ENABLEERASEMEMORYBEFOREFLASHING 0
#define MW_RUNTIME_GENERATEIDEPROJECT 0
#define MW_STM32CUBEMX_PROJECTFILEBUTTON 
#define MW_STM32CUBEMX_CREATEPROJECTFILEBUTTON 
#define MW_STM32CUBEMX_LAUNCHPROJECTFILEBUTTON 
#define MW_STM32CUBEMX_PROJECTFILE LKM_BNO086_Bringup.ioc
#define MW_STM32CUBEMX_DEVICEID STM32F405RGTx
#define MW_STM32CUBEMX_FAMILY STM32F4
#define MW_STM32CUBEMX_LINKERCUSTOMCONFIGUREMODULE 0
#define MW_STM32CUBEMX_LINKEREDIT "<Select linker file>"
#define MW_STM32CUBEMX_LINKERBROWSE 
#define MW_STM32CUBEMX_CONNECTIVITYMODE 0
#define MW_STM32CUBEMX_CONNECTIONPORT 0
#define MW_STM32CUBEMX_FREQUENCY 4000
#define MW_STM32CUBEMX_MODE 0
#define MW_STM32CUBEMX_ACCESSPORT 0
#define MW_STM32CUBEMX_RESETMODE 0
#define MW_STM32CUBEMX_AUTODETECTBOARD 0
#define MW_STM32CUBEMX_DEVICELIST None
#define MW_STM32CUBEMX_DEVICELISTREFRESH 
#define MW_CLOCKING_CPUCLOCKRATEMHZ 16.000000
#define MW_CONNECTION_SERIALCONFIGUREMODULE 0
#define MW_CONNECTION_SERIALMODULE 2
#define MW_CONNECTION_SERIALPORT "No serial port detected"
#define MW_CONNECTION_ETHERNETCONFIGUREMODULE 0
#define MW_CONNECTION_ETHERNETPORT 17725.000000
#define MW_CONNECTION_CANCONFIGUREMODULE 0
#define MW_CONNECTION_CANMODULE 0
#define MW_CONNECTION_BAUDRATE 1000000
#define MW_CONNECTION_CANREADSOURCE 0
#define MW_CONNECTION_CANVENDOR 
#define MW_CONNECTION_CANDEVICE 
#define MW_CONNECTION_CANCHANNEL 
#define MW_CONNECTION_ISCANIDEXTENDED 0
#define MW_CONNECTION_CANIDCOMMAND 2
#define MW_CONNECTION_CANIDRESPONSE 3
#define MW_CONNECTION_SERIALPORTREFRESH 
#define MW_CONNECTIVITY_REFRESH 
#define MW_SIMULINKIO_MODELTRANSPORTDATAFCN stm32cube.connectedIO.getConfigSetInfo
#define MW_SIMULINKIO_SERVERDEPLOYFCN stm32cube.connectedIO.updateServer
#define MW_SIMULINKIO_VALIDATESERVERFCN stm32cube.connectedIO.validateIoServer
#define MW_SIMULINKIO_INTERFACE 0
#define MW_SIMULINKIO_VALIDATEBEFORECONNECTFCN stm32cube.connectedIO.connectedIOModelValidation
#define MW_SIMULINKIO_CONNECTEDIOSUPPORTEDBLOCKS DigitalPortRead,DigitalPortWrite,PWMOutput,AnalogInput,I2CControllerRead,I2CControllerWrite,LSM6DS3Block,LSM6DS3HBlock,LSM6DSLBlock,LSM6DSMBlock,LSM6DSRBlock,LSM6DSOBlock,LSM303CBlock,LIS3MDLBlock,LPS22HBBlock,HTS221Block,BMI160Block,ADXL34xBlock,CCS811Block,ICM20948Block,LIS3DHBlock,BNO055Block,MPU6050Block,MPU9250Block,SPIControllerTransmit,SPIControllerReceive,SPIControllerTransfer,RegisterRW,CANRead,CANWrite
#define MW_CONNECTEDIO_CONNECTEDIOMODE 0
#define MW_CONNECTEDIO_ACTIONONOVERRUN 0
#define MW_USART_USART1CONFIGUREMODULE 0
#define MW_USART_USART2CONFIGUREMODULE 0
#define MW_USART_USART3CONFIGUREMODULE 0
#define MW_USART_UART4CONFIGUREMODULE 0
#define MW_USART_UART5CONFIGUREMODULE 0
#define MW_USART_USART6CONFIGUREMODULE 0
#define MW_USART_UART7CONFIGUREMODULE 0
#define MW_USART_UART8CONFIGUREMODULE 0
#define MW_USART_UART9CONFIGUREMODULE 0
#define MW_USART_UART10CONFIGUREMODULE 0
#define MW_USART1_TRANSMITMODE 0
#define MW_USART1_RECEIVEMODE 0
#define MW_USART1_TRANSMITBUFFERLENGTH 128
#define MW_USART1_RECEIVEBUFFERLENGTH 128
#define MW_USART1_DISABLEDMAINTERRUPTONERROR 0
#define MW_USART1_ENABLEMODBUS 0
#define MW_USART1_MODBUSMODE 0
#define MW_USART1_MODBUSSERVERID 0
#define MW_USART1_MODBUSGPIOPORT 0
#define MW_USART1_MODBUSGPIOPIN 0
#define MW_USART1_MODBUSENABLECOILS 0
#define MW_USART1_COILADDRESS 0
#define MW_USART1_COILQTY 1
#define MW_USART1_MODBUSENABLEDISCRETEINPUTS 0
#define MW_USART1_DISCINPADDRESS 0
#define MW_USART1_DISCINPQTY 1
#define MW_USART1_MODBUSENABLEHOLDINGREG 0
#define MW_USART1_HOLDREGADDRESS 0
#define MW_USART1_HOLDREGQTY 1
#define MW_USART1_MODBUSENABLEINPUTREG 0
#define MW_USART1_INPUTREGADDRESS 0
#define MW_USART1_INPUTREGQTY 1
#define MW_USART2_TRANSMITMODE 0
#define MW_USART2_RECEIVEMODE 0
#define MW_USART2_TRANSMITBUFFERLENGTH 128
#define MW_USART2_RECEIVEBUFFERLENGTH 128
#define MW_USART2_DISABLEDMAINTERRUPTONERROR 0
#define MW_USART2_ENABLEMODBUS 0
#define MW_USART2_MODBUSMODE 0
#define MW_USART2_MODBUSSERVERID 0
#define MW_USART2_MODBUSGPIOPORT 0
#define MW_USART2_MODBUSGPIOPIN 0
#define MW_USART2_MODBUSENABLECOILS 0
#define MW_USART2_COILADDRESS 0
#define MW_USART2_COILQTY 1
#define MW_USART2_MODBUSENABLEDISCRETEINPUTS 0
#define MW_USART2_DISCINPADDRESS 0
#define MW_USART2_DISCINPQTY 1
#define MW_USART2_MODBUSENABLEHOLDINGREG 0
#define MW_USART2_HOLDREGADDRESS 0
#define MW_USART2_HOLDREGQTY 1
#define MW_USART2_MODBUSENABLEINPUTREG 0
#define MW_USART2_INPUTREGADDRESS 0
#define MW_USART2_INPUTREGQTY 1
#define MW_USART3_TRANSMITMODE 0
#define MW_USART3_RECEIVEMODE 0
#define MW_USART3_TRANSMITBUFFERLENGTH 128
#define MW_USART3_RECEIVEBUFFERLENGTH 128
#define MW_USART3_DISABLEDMAINTERRUPTONERROR 0
#define MW_USART3_ENABLEMODBUS 0
#define MW_USART3_MODBUSMODE 0
#define MW_USART3_MODBUSSERVERID 0
#define MW_USART3_MODBUSGPIOPORT 0
#define MW_USART3_MODBUSGPIOPIN 0
#define MW_USART3_MODBUSENABLECOILS 0
#define MW_USART3_COILADDRESS 0
#define MW_USART3_COILQTY 1
#define MW_USART3_MODBUSENABLEDISCRETEINPUTS 0
#define MW_USART3_DISCINPADDRESS 0
#define MW_USART3_DISCINPQTY 1
#define MW_USART3_MODBUSENABLEHOLDINGREG 0
#define MW_USART3_HOLDREGADDRESS 0
#define MW_USART3_HOLDREGQTY 1
#define MW_USART3_MODBUSENABLEINPUTREG 0
#define MW_USART3_INPUTREGADDRESS 0
#define MW_USART3_INPUTREGQTY 1
#define MW_UART4_TRANSMITMODE 0
#define MW_UART4_RECEIVEMODE 0
#define MW_UART4_TRANSMITBUFFERLENGTH 128
#define MW_UART4_RECEIVEBUFFERLENGTH 128
#define MW_UART4_DISABLEDMAINTERRUPTONERROR 0
#define MW_UART4_ENABLEMODBUS 0
#define MW_UART4_MODBUSMODE 0
#define MW_UART4_MODBUSSERVERID 0
#define MW_UART4_MODBUSGPIOPORT 0
#define MW_UART4_MODBUSGPIOPIN 0
#define MW_UART4_MODBUSENABLECOILS 0
#define MW_UART4_COILADDRESS 0
#define MW_UART4_COILQTY 1
#define MW_UART4_MODBUSENABLEDISCRETEINPUTS 0
#define MW_UART4_DISCINPADDRESS 0
#define MW_UART4_DISCINPQTY 1
#define MW_UART4_MODBUSENABLEHOLDINGREG 0
#define MW_UART4_HOLDREGADDRESS 0
#define MW_UART4_HOLDREGQTY 1
#define MW_UART4_MODBUSENABLEINPUTREG 0
#define MW_UART4_INPUTREGADDRESS 0
#define MW_UART4_INPUTREGQTY 1
#define MW_UART5_TRANSMITMODE 0
#define MW_UART5_RECEIVEMODE 0
#define MW_UART5_TRANSMITBUFFERLENGTH 128
#define MW_UART5_RECEIVEBUFFERLENGTH 128
#define MW_UART5_DISABLEDMAINTERRUPTONERROR 0
#define MW_UART5_ENABLEMODBUS 0
#define MW_UART5_MODBUSMODE 0
#define MW_UART5_MODBUSSERVERID 0
#define MW_UART5_MODBUSGPIOPORT 0
#define MW_UART5_MODBUSGPIOPIN 0
#define MW_UART5_MODBUSENABLECOILS 0
#define MW_UART5_COILADDRESS 0
#define MW_UART5_COILQTY 1
#define MW_UART5_MODBUSENABLEDISCRETEINPUTS 0
#define MW_UART5_DISCINPADDRESS 0
#define MW_UART5_DISCINPQTY 1
#define MW_UART5_MODBUSENABLEHOLDINGREG 0
#define MW_UART5_HOLDREGADDRESS 0
#define MW_UART5_HOLDREGQTY 1
#define MW_UART5_MODBUSENABLEINPUTREG 0
#define MW_UART5_INPUTREGADDRESS 0
#define MW_UART5_INPUTREGQTY 1
#define MW_USART6_TRANSMITMODE 0
#define MW_USART6_RECEIVEMODE 0
#define MW_USART6_TRANSMITBUFFERLENGTH 128
#define MW_USART6_RECEIVEBUFFERLENGTH 128
#define MW_USART6_DISABLEDMAINTERRUPTONERROR 0
#define MW_USART6_ENABLEMODBUS 0
#define MW_USART6_MODBUSMODE 0
#define MW_USART6_MODBUSSERVERID 0
#define MW_USART6_MODBUSGPIOPORT 0
#define MW_USART6_MODBUSGPIOPIN 0
#define MW_USART6_MODBUSENABLECOILS 0
#define MW_USART6_COILADDRESS 0
#define MW_USART6_COILQTY 1
#define MW_USART6_MODBUSENABLEDISCRETEINPUTS 0
#define MW_USART6_DISCINPADDRESS 0
#define MW_USART6_DISCINPQTY 1
#define MW_USART6_MODBUSENABLEHOLDINGREG 0
#define MW_USART6_HOLDREGADDRESS 0
#define MW_USART6_HOLDREGQTY 1
#define MW_USART6_MODBUSENABLEINPUTREG 0
#define MW_USART6_INPUTREGADDRESS 0
#define MW_USART6_INPUTREGQTY 1
#define MW_UART7_TRANSMITMODE 0
#define MW_UART7_RECEIVEMODE 0
#define MW_UART7_TRANSMITBUFFERLENGTH 128
#define MW_UART7_RECEIVEBUFFERLENGTH 128
#define MW_UART7_DISABLEDMAINTERRUPTONERROR 0
#define MW_UART7_ENABLEMODBUS 0
#define MW_UART7_MODBUSMODE 0
#define MW_UART7_MODBUSSERVERID 0
#define MW_UART7_MODBUSGPIOPORT 0
#define MW_UART7_MODBUSGPIOPIN 0
#define MW_UART7_MODBUSENABLECOILS 0
#define MW_UART7_COILADDRESS 0
#define MW_UART7_COILQTY 1
#define MW_UART7_MODBUSENABLEDISCRETEINPUTS 0
#define MW_UART7_DISCINPADDRESS 0
#define MW_UART7_DISCINPQTY 1
#define MW_UART7_MODBUSENABLEHOLDINGREG 0
#define MW_UART7_HOLDREGADDRESS 0
#define MW_UART7_HOLDREGQTY 1
#define MW_UART7_MODBUSENABLEINPUTREG 0
#define MW_UART7_INPUTREGADDRESS 0
#define MW_UART7_INPUTREGQTY 1
#define MW_UART8_TRANSMITMODE 0
#define MW_UART8_RECEIVEMODE 0
#define MW_UART8_TRANSMITBUFFERLENGTH 128
#define MW_UART8_RECEIVEBUFFERLENGTH 128
#define MW_UART8_DISABLEDMAINTERRUPTONERROR 0
#define MW_UART8_ENABLEMODBUS 0
#define MW_UART8_MODBUSMODE 0
#define MW_UART8_MODBUSSERVERID 0
#define MW_UART8_MODBUSGPIOPORT 0
#define MW_UART8_MODBUSGPIOPIN 0
#define MW_UART8_MODBUSENABLECOILS 0
#define MW_UART8_COILADDRESS 0
#define MW_UART8_COILQTY 1
#define MW_UART8_MODBUSENABLEDISCRETEINPUTS 0
#define MW_UART8_DISCINPADDRESS 0
#define MW_UART8_DISCINPQTY 1
#define MW_UART8_MODBUSENABLEHOLDINGREG 0
#define MW_UART8_HOLDREGADDRESS 0
#define MW_UART8_HOLDREGQTY 1
#define MW_UART8_MODBUSENABLEINPUTREG 0
#define MW_UART8_INPUTREGADDRESS 0
#define MW_UART8_INPUTREGQTY 1
#define MW_UART9_TRANSMITMODE 0
#define MW_UART9_RECEIVEMODE 0
#define MW_UART9_TRANSMITBUFFERLENGTH 128
#define MW_UART9_RECEIVEBUFFERLENGTH 128
#define MW_UART9_DISABLEDMAINTERRUPTONERROR 0
#define MW_UART9_ENABLEMODBUS 0
#define MW_UART9_MODBUSMODE 0
#define MW_UART9_MODBUSSERVERID 0
#define MW_UART9_MODBUSGPIOPORT 0
#define MW_UART9_MODBUSGPIOPIN 0
#define MW_UART9_MODBUSENABLECOILS 0
#define MW_UART9_COILADDRESS 0
#define MW_UART9_COILQTY 1
#define MW_UART9_MODBUSENABLEDISCRETEINPUTS 0
#define MW_UART9_DISCINPADDRESS 0
#define MW_UART9_DISCINPQTY 1
#define MW_UART9_MODBUSENABLEHOLDINGREG 0
#define MW_UART9_HOLDREGADDRESS 0
#define MW_UART9_HOLDREGQTY 1
#define MW_UART9_MODBUSENABLEINPUTREG 0
#define MW_UART9_INPUTREGADDRESS 0
#define MW_UART9_INPUTREGQTY 1
#define MW_UART10_TRANSMITMODE 0
#define MW_UART10_RECEIVEMODE 0
#define MW_UART10_TRANSMITBUFFERLENGTH 128
#define MW_UART10_RECEIVEBUFFERLENGTH 128
#define MW_UART10_DISABLEDMAINTERRUPTONERROR 0
#define MW_UART10_ENABLEMODBUS 0
#define MW_UART10_MODBUSMODE 0
#define MW_UART10_MODBUSSERVERID 0
#define MW_UART10_MODBUSGPIOPORT 0
#define MW_UART10_MODBUSGPIOPIN 0
#define MW_UART10_MODBUSENABLECOILS 0
#define MW_UART10_COILADDRESS 0
#define MW_UART10_COILQTY 1
#define MW_UART10_MODBUSENABLEDISCRETEINPUTS 0
#define MW_UART10_DISCINPADDRESS 0
#define MW_UART10_DISCINPQTY 1
#define MW_UART10_MODBUSENABLEHOLDINGREG 0
#define MW_UART10_HOLDREGADDRESS 0
#define MW_UART10_HOLDREGQTY 1
#define MW_UART10_MODBUSENABLEINPUTREG 0
#define MW_UART10_INPUTREGADDRESS 0
#define MW_UART10_INPUTREGQTY 1
#define MW_ETHERNET_HOSTNAME STM32F4xx
#define MW_ETHERNET_MACADDR 00:80:E1:00:00:00
#define MW_ETHERNET_DHCPENABLED 1
#define MW_ETHERNET_LOCALIPADDRESS 0.0.0.0
#define MW_ETHERNET_SUBNETMASK 0.0.0.0
#define MW_ETHERNET_GATEWAY 0.0.0.0
#define MW_ADC1_USEDMA 0
#define MW_ADC1_USEWATCHDOG 0
#define MW_ADC1_EOCENABLEINTERRUPT 0
#define MW_ADC1_JEOCENABLEINTERRUPT 0
#define MW_ADC1_OVRENABLEINTERRUPT 0
#define MW_ADC1_REFRESH 
#define MW_ADC2_USEDMA 0
#define MW_ADC2_USEWATCHDOG 0
#define MW_ADC2_EOCENABLEINTERRUPT 0
#define MW_ADC2_JEOCENABLEINTERRUPT 0
#define MW_ADC2_OVRENABLEINTERRUPT 0
#define MW_ADC2_REFRESH 
#define MW_ADC3_USEDMA 0
#define MW_ADC3_USEWATCHDOG 0
#define MW_ADC3_EOCENABLEINTERRUPT 0
#define MW_ADC3_JEOCENABLEINTERRUPT 0
#define MW_ADC3_OVRENABLEINTERRUPT 0
#define MW_ADC3_REFRESH 
#define MW_SPI_SPIMODULESELECT 0
#define MW_SPI1_TRANSMITMODE 2
#define MW_SPI1_TRANSMITBUFFERLENGTH 128
#define MW_SPI1_RECEIVEMODE 2
#define MW_SPI1_RECEIVEBUFFERLENGTH 128
#define MW_SPI1_RXFIFOINTERRUPT 0
#define MW_SPI1_ERRORINTERRUPT 0
#define MW_SPI2_TRANSMITMODE 2
#define MW_SPI2_TRANSMITBUFFERLENGTH 128
#define MW_SPI2_RECEIVEMODE 2
#define MW_SPI2_RECEIVEBUFFERLENGTH 128
#define MW_SPI2_RXFIFOINTERRUPT 0
#define MW_SPI2_ERRORINTERRUPT 0
#define MW_SPI3_TRANSMITMODE 2
#define MW_SPI3_TRANSMITBUFFERLENGTH 128
#define MW_SPI3_RECEIVEMODE 2
#define MW_SPI3_RECEIVEBUFFERLENGTH 128
#define MW_SPI3_RXFIFOINTERRUPT 0
#define MW_SPI3_ERRORINTERRUPT 0
#define MW_SPI4_TRANSMITMODE 2
#define MW_SPI4_TRANSMITBUFFERLENGTH 128
#define MW_SPI4_RECEIVEMODE 2
#define MW_SPI4_RECEIVEBUFFERLENGTH 128
#define MW_SPI4_RXFIFOINTERRUPT 0
#define MW_SPI4_ERRORINTERRUPT 0
#define MW_SPI5_TRANSMITMODE 2
#define MW_SPI5_TRANSMITBUFFERLENGTH 128
#define MW_SPI5_RECEIVEMODE 2
#define MW_SPI5_RECEIVEBUFFERLENGTH 128
#define MW_SPI5_RXFIFOINTERRUPT 0
#define MW_SPI5_ERRORINTERRUPT 0
#define MW_SPI6_TRANSMITMODE 2
#define MW_SPI6_TRANSMITBUFFERLENGTH 128
#define MW_SPI6_RECEIVEMODE 2
#define MW_SPI6_RECEIVEBUFFERLENGTH 128
#define MW_SPI6_RXFIFOINTERRUPT 0
#define MW_SPI6_ERRORINTERRUPT 0
#define MW_TIMER_TIMERGROUP 0
#define MW_TIMER_TIM1CONFIGUREMODULE 0
#define MW_TIMER_TIM8CONFIGUREMODULE 0
#define MW_TIMER_TIM2CONFIGUREMODULE 0
#define MW_TIMER_TIM3CONFIGUREMODULE 0
#define MW_TIMER_TIM4CONFIGUREMODULE 0
#define MW_TIMER_TIM5CONFIGUREMODULE 0
#define MW_TIMER_TIM6CONFIGUREMODULE 0
#define MW_TIMER_TIM7CONFIGUREMODULE 0
#define MW_TIMER_TIM9CONFIGUREMODULE 0
#define MW_TIMER_TIM10CONFIGUREMODULE 0
#define MW_TIMER_TIM11CONFIGUREMODULE 0
#define MW_TIMER_TIM12CONFIGUREMODULE 0
#define MW_TIMER_TIM13CONFIGUREMODULE 0
#define MW_TIMER_TIM14CONFIGUREMODULE 0
#define MW_TIM1_STARTTIMER 1
#define MW_TIM1_TRIGGERINTERRUPT 0
#define MW_TIM1_CAPTURECOMPARE1INTERRUPT 0
#define MW_TIM1_CAPTURECOMPARE2INTERRUPT 0
#define MW_TIM1_CAPTURECOMPARE3INTERRUPT 0
#define MW_TIM1_CAPTURECOMPARE4INTERRUPT 0
#define MW_TIM1_UPDATEINTERRUPT 0
#define MW_TIM1_BREAKINTERRUPT 0
#define MW_TIM1_COMINTERRUPT 0
#define MW_TIM8_STARTTIMER 1
#define MW_TIM8_TRIGGERINTERRUPT 0
#define MW_TIM8_CAPTURECOMPARE1INTERRUPT 0
#define MW_TIM8_CAPTURECOMPARE2INTERRUPT 0
#define MW_TIM8_CAPTURECOMPARE3INTERRUPT 0
#define MW_TIM8_CAPTURECOMPARE4INTERRUPT 0
#define MW_TIM8_UPDATEINTERRUPT 0
#define MW_TIM8_BREAKINTERRUPT 0
#define MW_TIM8_COMINTERRUPT 0
#define MW_TIM2_STARTTIMER 1
#define MW_TIM2_TRIGGERINTERRUPT 0
#define MW_TIM2_CAPTURECOMPARE1INTERRUPT 0
#define MW_TIM2_CAPTURECOMPARE2INTERRUPT 0
#define MW_TIM2_CAPTURECOMPARE3INTERRUPT 0
#define MW_TIM2_CAPTURECOMPARE4INTERRUPT 0
#define MW_TIM2_UPDATEINTERRUPT 0
#define MW_TIM3_STARTTIMER 1
#define MW_TIM3_TRIGGERINTERRUPT 0
#define MW_TIM3_CAPTURECOMPARE1INTERRUPT 0
#define MW_TIM3_CAPTURECOMPARE2INTERRUPT 0
#define MW_TIM3_CAPTURECOMPARE3INTERRUPT 0
#define MW_TIM3_CAPTURECOMPARE4INTERRUPT 0
#define MW_TIM3_UPDATEINTERRUPT 0
#define MW_TIM4_STARTTIMER 1
#define MW_TIM4_TRIGGERINTERRUPT 0
#define MW_TIM4_CAPTURECOMPARE1INTERRUPT 0
#define MW_TIM4_CAPTURECOMPARE2INTERRUPT 0
#define MW_TIM4_CAPTURECOMPARE3INTERRUPT 0
#define MW_TIM4_CAPTURECOMPARE4INTERRUPT 0
#define MW_TIM4_UPDATEINTERRUPT 0
#define MW_TIM5_STARTTIMER 1
#define MW_TIM5_TRIGGERINTERRUPT 0
#define MW_TIM5_CAPTURECOMPARE1INTERRUPT 0
#define MW_TIM5_CAPTURECOMPARE2INTERRUPT 0
#define MW_TIM5_CAPTURECOMPARE3INTERRUPT 0
#define MW_TIM5_CAPTURECOMPARE4INTERRUPT 0
#define MW_TIM5_UPDATEINTERRUPT 0
#define MW_TIM6_STARTTIMER 1
#define MW_TIM6_UPDATEINTERRUPT 0
#define MW_TIM7_STARTTIMER 1
#define MW_TIM7_UPDATEINTERRUPT 0
#define MW_TIM9_STARTTIMER 1
#define MW_TIM9_TRIGGERINTERRUPT 0
#define MW_TIM9_CAPTURECOMPARE1INTERRUPT 0
#define MW_TIM9_CAPTURECOMPARE2INTERRUPT 0
#define MW_TIM9_UPDATEINTERRUPT 0
#define MW_TIM10_STARTTIMER 1
#define MW_TIM10_CAPTURECOMPARE1INTERRUPT 0
#define MW_TIM10_UPDATEINTERRUPT 0
#define MW_TIM11_STARTTIMER 1
#define MW_TIM11_CAPTURECOMPARE1INTERRUPT 0
#define MW_TIM11_UPDATEINTERRUPT 0
#define MW_TIM12_STARTTIMER 1
#define MW_TIM12_TRIGGERINTERRUPT 0
#define MW_TIM12_CAPTURECOMPARE1INTERRUPT 0
#define MW_TIM12_CAPTURECOMPARE2INTERRUPT 0
#define MW_TIM12_UPDATEINTERRUPT 0
#define MW_TIM13_STARTTIMER 1
#define MW_TIM13_CAPTURECOMPARE1INTERRUPT 0
#define MW_TIM13_UPDATEINTERRUPT 0
#define MW_TIM14_STARTTIMER 1
#define MW_TIM14_CAPTURECOMPARE1INTERRUPT 0
#define MW_TIM14_UPDATEINTERRUPT 0
#define MW_CAN_MODULE 0
#define MW_CAN1_BAUDRATE 1000000
#define MW_CAN1_ENABLETXSWFIFO 0
#define MW_CAN1_TXSWFIFODEPTH 128
#define MW_CAN1_ENABLERXSWFIFO0 0
#define MW_CAN1_RXSWFIFO0DEPTH 128
#define MW_CAN1_RXSWFIFO0OVERWRITEMODE 0
#define MW_CAN1_ENABLERXSWFIFO1 0
#define MW_CAN1_RXSWFIFO1DEPTH 128
#define MW_CAN1_RXSWFIFO1OVERWRITEMODE 0
#define MW_CAN1_CONFIGUREINTENRX 0
#define MW_CAN1_CONFIGUREINTFIFO0RX 0
#define MW_CAN1_ENABLEFIFO0MSGPENDINGINTR 0
#define MW_CAN1_ENABLEFIFO0FULLINTR 0
#define MW_CAN1_ENABLEFIFO0OVRINTR 0
#define MW_CAN1_CONFIGUREINTFIFO1RX 0
#define MW_CAN1_ENABLEFIFO1MSGPENDINGINTR 0
#define MW_CAN1_ENABLEFIFO1FULLINTR 0
#define MW_CAN1_ENABLEFIFO1OVRINTR 0
#define MW_CAN1_CONFIGUREINTENTX 0
#define MW_CAN1_ENABLETXMAILBOXEMPTYINTR 0
#define MW_CAN1_CONFIGUREINTENOTHER 0
#define MW_CAN1_ENABLEERRWARNINTR 0
#define MW_CAN1_ENABLEERRPASSIVEINTR 0
#define MW_CAN1_ENABLEBUSOFFINTR 0
#define MW_CAN1_ENABLELASTERRCODEINTR 0
#define MW_CAN1_ENABLEWAKEUPINTR 0
#define MW_CAN1_ENABLESLEEPACKINTR 0
#define MW_CAN1_ACCEPTALLMESSAGES 1
#define MW_CAN1_FILTERBANKNUMBER 0
#define MW_CAN1_ENABLEFILTERBANK00 0
#define MW_CAN1_SCALE00 0
#define MW_CAN1_MODE00 0
#define MW_CAN1_FIFOASSIGNMENT00 0
#define MW_CAN1_IDTYPE00 0
#define MW_CAN1_ID1_00 0
#define MW_CAN1_MASK1_00 0
#define MW_CAN1_ID2_00 0
#define MW_CAN1_MASK2_00 0
#define MW_CAN1_ID3_00 0
#define MW_CAN1_ID4_00 0
#define MW_CAN1_ENABLEFILTERBANK01 0
#define MW_CAN1_SCALE01 0
#define MW_CAN1_MODE01 0
#define MW_CAN1_FIFOASSIGNMENT01 0
#define MW_CAN1_IDTYPE01 0
#define MW_CAN1_ID1_01 0
#define MW_CAN1_MASK1_01 0
#define MW_CAN1_ID2_01 0
#define MW_CAN1_MASK2_01 0
#define MW_CAN1_ID3_01 0
#define MW_CAN1_ID4_01 0
#define MW_CAN1_ENABLEFILTERBANK02 0
#define MW_CAN1_SCALE02 0
#define MW_CAN1_MODE02 0
#define MW_CAN1_FIFOASSIGNMENT02 0
#define MW_CAN1_IDTYPE02 0
#define MW_CAN1_ID1_02 0
#define MW_CAN1_MASK1_02 0
#define MW_CAN1_ID2_02 0
#define MW_CAN1_MASK2_02 0
#define MW_CAN1_ID3_02 0
#define MW_CAN1_ID4_02 0
#define MW_CAN1_ENABLEFILTERBANK03 0
#define MW_CAN1_SCALE03 0
#define MW_CAN1_MODE03 0
#define MW_CAN1_FIFOASSIGNMENT03 0
#define MW_CAN1_IDTYPE03 0
#define MW_CAN1_ID1_03 0
#define MW_CAN1_MASK1_03 0
#define MW_CAN1_ID2_03 0
#define MW_CAN1_MASK2_03 0
#define MW_CAN1_ID3_03 0
#define MW_CAN1_ID4_03 0
#define MW_CAN1_ENABLEFILTERBANK04 0
#define MW_CAN1_SCALE04 0
#define MW_CAN1_MODE04 0
#define MW_CAN1_FIFOASSIGNMENT04 0
#define MW_CAN1_IDTYPE04 0
#define MW_CAN1_ID1_04 0
#define MW_CAN1_MASK1_04 0
#define MW_CAN1_ID2_04 0
#define MW_CAN1_MASK2_04 0
#define MW_CAN1_ID3_04 0
#define MW_CAN1_ID4_04 0
#define MW_CAN1_ENABLEFILTERBANK05 0
#define MW_CAN1_SCALE05 0
#define MW_CAN1_MODE05 0
#define MW_CAN1_FIFOASSIGNMENT05 0
#define MW_CAN1_IDTYPE05 0
#define MW_CAN1_ID1_05 0
#define MW_CAN1_MASK1_05 0
#define MW_CAN1_ID2_05 0
#define MW_CAN1_MASK2_05 0
#define MW_CAN1_ID3_05 0
#define MW_CAN1_ID4_05 0
#define MW_CAN1_ENABLEFILTERBANK06 0
#define MW_CAN1_SCALE06 0
#define MW_CAN1_MODE06 0
#define MW_CAN1_FIFOASSIGNMENT06 0
#define MW_CAN1_IDTYPE06 0
#define MW_CAN1_ID1_06 0
#define MW_CAN1_MASK1_06 0
#define MW_CAN1_ID2_06 0
#define MW_CAN1_MASK2_06 0
#define MW_CAN1_ID3_06 0
#define MW_CAN1_ID4_06 0
#define MW_CAN1_ENABLEFILTERBANK07 0
#define MW_CAN1_SCALE07 0
#define MW_CAN1_MODE07 0
#define MW_CAN1_FIFOASSIGNMENT07 0
#define MW_CAN1_IDTYPE07 0
#define MW_CAN1_ID1_07 0
#define MW_CAN1_MASK1_07 0
#define MW_CAN1_ID2_07 0
#define MW_CAN1_MASK2_07 0
#define MW_CAN1_ID3_07 0
#define MW_CAN1_ID4_07 0
#define MW_CAN1_ENABLEFILTERBANK08 0
#define MW_CAN1_SCALE08 0
#define MW_CAN1_MODE08 0
#define MW_CAN1_FIFOASSIGNMENT08 0
#define MW_CAN1_IDTYPE08 0
#define MW_CAN1_ID1_08 0
#define MW_CAN1_MASK1_08 0
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
#define MW_CAN3_SCALE07 0
#define MW_CAN3_MODE07 0
#define MW_CAN3_FIFOASSIGNMENT07 0
#define MW_CAN3_IDTYPE07 0
#define MW_CAN3_ID1_07 0
#define MW_CAN3_MASK1_07 0
#define MW_CAN3_ID2_07 0
#define MW_CAN3_MASK2_07 0
#define MW_CAN3_ID3_07 0
#define MW_CAN3_ID4_07 0
#define MW_CAN3_ENABLEFILTERBANK08 0
#define MW_CAN3_SCALE08 0
#define MW_CAN3_MODE08 0
#define MW_CAN3_FIFOASSIGNMENT08 0
#define MW_CAN3_IDTYPE08 0
#define MW_CAN3_ID1_08 0
#define MW_CAN3_MASK1_08 0
#define MW_CAN3_ID2_08 0
#define MW_CAN3_MASK2_08 0
#define MW_CAN3_ID3_08 0
#define MW_CAN3_ID4_08 0
#define MW_CAN3_ENABLEFILTERBANK09 0
#define MW_CAN3_SCALE09 0
#define MW_CAN3_MODE09 0
#define MW_CAN3_FIFOASSIGNMENT09 0
#define MW_CAN3_IDTYPE09 0
#define MW_CAN3_ID1_09 0
#define MW_CAN3_MASK1_09 0
#define MW_CAN3_ID2_09 0
#define MW_CAN3_MASK2_09 0
#define MW_CAN3_ID3_09 0
#define MW_CAN3_ID4_09 0
#define MW_CAN3_ENABLEFILTERBANK10 0
#define MW_CAN3_SCALE10 0
#define MW_CAN3_MODE10 0
#define MW_CAN3_FIFOASSIGNMENT10 0
#define MW_CAN3_IDTYPE10 0
#define MW_CAN3_ID1_10 0
#define MW_CAN3_MASK1_10 0
#define MW_CAN3_ID2_10 0
#define MW_CAN3_MASK2_10 0
#define MW_CAN3_ID3_10 0
#define MW_CAN3_ID4_10 0
#define MW_CAN3_ENABLEFILTERBANK11 0
#define MW_CAN3_SCALE11 0
#define MW_CAN3_MODE11 0
#define MW_CAN3_FIFOASSIGNMENT11 0
#define MW_CAN3_IDTYPE11 0
#define MW_CAN3_ID1_11 0
#define MW_CAN3_MASK1_11 0
#define MW_CAN3_ID2_11 0
#define MW_CAN3_MASK2_11 0
#define MW_CAN3_ID3_11 0
#define MW_CAN3_ID4_11 0
#define MW_CAN3_ENABLEFILTERBANK12 0
#define MW_CAN3_SCALE12 0
#define MW_CAN3_MODE12 0
#define MW_CAN3_FIFOASSIGNMENT12 0
#define MW_CAN3_IDTYPE12 0
#define MW_CAN3_ID1_12 0
#define MW_CAN3_MASK1_12 0
#define MW_CAN3_ID2_12 0
#define MW_CAN3_MASK2_12 0
#define MW_CAN3_ID3_12 0
#define MW_CAN3_ID4_12 0
#define MW_CAN3_ENABLEFILTERBANK13 0
#define MW_CAN3_SCALE13 0
#define MW_CAN3_MODE13 0
#define MW_CAN3_FIFOASSIGNMENT13 0
#define MW_CAN3_IDTYPE13 0
#define MW_CAN3_ID1_13 0
#define MW_CAN3_MASK1_13 0
#define MW_CAN3_ID2_13 0
#define MW_CAN3_MASK2_13 0
#define MW_CAN3_ID3_13 0
#define MW_CAN3_ID4_13 0
#define MW_MQTT_BROKERSERVICE 0
#define MW_MQTT_BROKERADDRESS mqtt3.thingspeak.com
#define MW_MQTT_PORT 1883
#define MW_MQTT_CID NULL
#define MW_MQTT_USERNAME NULL
#define MW_MQTT_DELETEFILES 1
#define MW_PIL_INTERFACE 0
#define MW_I2S_I2SPDMFILTERCUBEMXCONFIGUREMODULE 0
#define MW_I2S_I2S1PDMCONFIGUREMODULE 0
#define MW_I2S_I2S1PDM_CHANNELS_1 1
#define MW_I2S_I2S1PDM_CHANNELS_2 2
#define MW_I2S_I2S2PDMCONFIGUREMODULE 0
#define MW_I2S_I2S2PDM_CHANNELS_1 1
#define MW_I2S_I2S2PDM_CHANNELS_2 2
#define MW_I2S_I2S3PDMCONFIGUREMODULE 0
#define MW_I2S_I2S3PDM_CHANNELS_1 1
#define MW_I2S_I2S3PDM_CHANNELS_2 2
#define MW_I2S_SCHEDULINGSELECTION 0
#define MW_SDCLOG_ENABLELOGGING 0
#define MW_SDCLOG_TYPE 0
#define MW_SDCLOG_INTERFACE 0
#define MW_SDCLOG_ENABLELOGGINGSTATUS 0
#define MW_SDCLOG_LOGGINGSTATUSGPIOGROUP 0
#define MW_SDCLOG_LOGGINGSTATUSGPIOPIN 1
#define MW_SENSOR_FILELOCATION stm32cube.sensors
#define MW_IOBLOCKSMODE deployed
#define MW_DATAVERSION 2016.02

#endif /* __MW_TARGET_HARDWARE_RESOURCES_H__ */

#endif

#endif
