hjus36/STM32-Flight-System/firmware/stm32/LKM_BNO086_Bringup/Core/Inc/main.h

#define ICM_CS_Pin GPIO_PIN_4
#define ICM_CS_GPIO_Port GPIOC
#define ICM_INT_Pin GPIO_PIN_5
#define ICM_INT_GPIO_Port GPIOC
#define BNO_CS_Pin GPIO_PIN_12
#define BNO_CS_GPIO_Port GPIOB
#define BNO_INTN_Pin GPIO_PIN_8
#define BNO_INTN_GPIO_Port GPIOC
#define BNO_RST_Pin GPIO_PIN_9
#define BNO_RST_GPIO_Port GPIOC
#define BNO_PS0_WAKE_Pin GPIO_PIN_8
#define BNO_PS0_WAKE_GPIO_Port GPIOA
