hjus36/STM32-Flight-System/firmware/stm32/LKM_BNO086_Bringup/Core/Inc/complex_types.h

/*
 * Academic License - for use in teaching, academic research, and meeting
 * course requirements at degree granting institutions only.  Not for
 * government, commercial, or other organizational use.
 *
 * File: complex_types.h
 *
 * Code generated for Simulink model 'LKM_AW_Core_F405'.
 *
 * Model version                  : 1.5
 * Simulink Coder version         : 26.2 (R2026b) 22-May-2026
 * C/C++ source code generated on : Thu Nov  5 16:45:34 2026
 */

/*
 * Academic License - for use in teaching, academic research, and meeting
 * course requirements at degree granting institutions only.  Not for
 * government, commercial, or other organizational use.
 *
 * File: complex_types.h
 *
 * Code generated for Simulink model 'LKM_AW_Core_F405'.
 *
 * Model version                  : 1.5
 * Simulink Coder version         : 26.2 (R2026b) 22-May-2026
 * C/C++ source code generated on : Thu Nov  5 16:35:50 2026
 */
#ifndef COMPLEX_TYPES_H
#define COMPLEX_TYPES_H
#include <stdint.h>

/*===========================================================================*
 * Complex number type definitions                                           *
 *===========================================================================*/
#define CREAL_T

typedef struct {
  float re;
  float im;
} creal32_T;

typedef struct {
  double re;
  double im;
} creal_T;

typedef creal_T creal64_T;

#define CINT8_T

typedef struct {
  int8_t re;
  int8_t im;
} cint8_T;

#define CUINT8_T

typedef struct {
  uint8_t re;
  uint8_t im;
} cuint8_T;

#define CINT16_T

typedef struct {
  int16_t re;
  int16_t im;
} cint16_T;

#define CUINT16_T

typedef struct {
  uint16_t re;
  uint16_t im;
} cuint16_T;

#define CINT32_T

typedef struct {
  int32_t re;
  int32_t im;
} cint32_T;

#define CUINT32_T

typedef struct {
  uint32_t re;
  uint32_t im;
} cuint32_T;

#define CINT64_T

typedef struct {
  int64_t re;
  int64_t im;
} cint64_T;

#define CUINT64_T

typedef struct {
  uint64_t re;
  uint64_t im;
} cuint64_T;

#endif                                 /* COMPLEX_TYPES_H */

/*
 * File trailer for generated code.
 *
 * [EOF]
 */

/*
 * File trailer for generated code.
 *
 * [EOF]
 */
