hjus36/STM32-Flight-System/firmware/stm32/LKM_BNO086_Bringup/Core/Src/const_params.c

/*
 * const_params.c
 *
 * Academic License - for use in teaching, academic research, and meeting
 * course requirements at degree granting institutions only.  Not for
 * government, commercial, or other organizational use.
 *
 * Code generation for model "LKM_AW_Core_F405".
 *
 * Model version              : 1.5
 * Simulink Coder version : 26.2 (R2026b) 22-May-2026
 * C source code generated on : Thu Nov  5 16:35:50 2026
 */
#include <stdbool.h>
#include <stdint.h>
#include "complex_types.h"

extern const float rtCP_pooled_HkVECsDp1mOJ;
const float rtCP_pooled_HkVECsDp1mOJ = 0.0F;
extern const float rtCP_pooled_SE6vMLHTpUXp[16];
const float rtCP_pooled_SE6vMLHTpUXp[16] = { 0.25F, 0.25F, 0.25F, 0.25F,
  -3.3671751F, -3.3671751F, 3.3671751F, 3.3671751F, -3.3671751F, 3.3671751F,
  -3.3671751F, 3.3671751F, 0.0F, 0.0F, 0.0F, 0.0F } ;

extern const float rtCP_pooled_stbNgMQSavpU[12];
const float rtCP_pooled_stbNgMQSavpU[12] = { 1.0F, -0.0742462128F,
  -0.0742462128F, 1.0F, -0.0742462128F, 0.0742462128F, 1.0F, 0.0742462128F,
  -0.0742462128F, 1.0F, 0.0742462128F, 0.0742462128F } ;
