hjus36/STM32-Flight-System/firmware/stm32/LKM_BNO086_Bringup/Core/Src/rt_nonfinite.c

/*
 * Academic License - for use in teaching, academic research, and meeting
 * course requirements at degree granting institutions only.  Not for
 * government, commercial, or other organizational use.
 *
 * File: rt_nonfinite.c
 *
 * Code generated for Simulink model 'LKM_AW_Mixer_F405'.
 *
 * Model version                  : 1.12
 * Simulink Coder version         : 26.2 (R2026b) 22-May-2026
 * C/C++ source code generated on : Thu Nov  5 16:35:45 2026
 */

#include <stdbool.h>
#include "rt_nonfinite.h"
#include "math.h"

double rtNaN = -(double)NAN;
double rtInf = (double)INFINITY;
double rtMinusInf = -(double)INFINITY;
float rtNaNF = -(float)NAN;
float rtInfF = (float)INFINITY;
float rtMinusInfF = -(float)INFINITY;

/* Test if value is infinite */
bool rtIsInf(double value)
{
  return (bool)isinf(value);
}

/* Test if single-precision value is infinite */
bool rtIsInfF(float value)
{
  return (bool)isinf(value);
}

/* Test if value is not a number */
bool rtIsNaN(double value)
{
  return (bool)(isnan(value) != 0);
}

/* Test if single-precision value is not a number */
bool rtIsNaNF(float value)
{
  return (bool)(isnan(value) != 0);
}

/*
 * File trailer for generated code.
 *
 * [EOF]
 */
