hjus36/STM32-Flight-System/(commit log)

2026-11-02 docs: initialize STM32 Flight System portfolio
2026-11-05 docs: publish validated control and firmware portfolio
    [roll_double_pid_summary.csv, roll_pid_comparison.csv, roll_pitch_normalized_comparison.csv, roll_pitch_summary.csv, trace_all_scenarios.csv]
2026-11-06 docs: add LKM_FC_V1 PCB 3D views and refine documentation
2026-11-06 docs: display PCB 3D views at half width
