hjus36/STM32-Flight-System/(notices)

Notices in the files:
firmware/stm32/LKM_BNO086_Bringup/Core/Src/main.c:
Copyright (c) 2026 STMicroelectronics.
All rights reserved.
This software is licensed under terms that can be found in the LICENSE file
